sdejana/ColorSorter_C/scheme/gotova_PCB_2.png

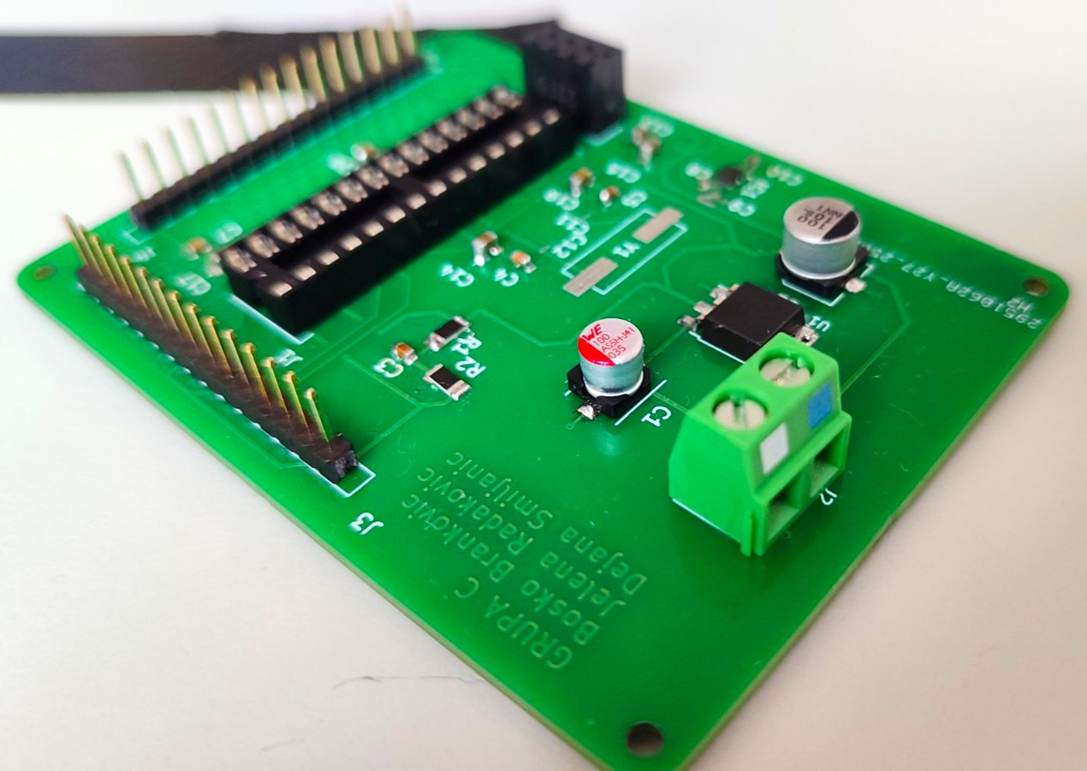
scheme/gotova_PCB_2.png
