sdejana/ColorSorter_C/scheme/3d_izgled_plocice.png

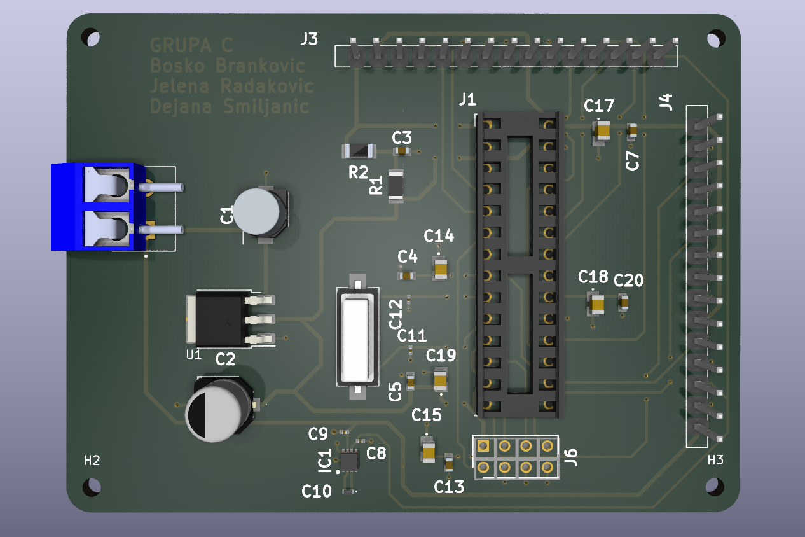
scheme/3d_izgled_plocice.png
