sdejana/ColorSorter_C/code/docs/latex/interrupt__manager_8h_source.tex

\doxysection{interrupt\+\_\+manager.\+h}
\hypertarget{interrupt__manager_8h_source}{}\label{interrupt__manager_8h_source}\index{include/interrupt\_manager.h@{include/interrupt\_manager.h}}
\mbox{\hyperlink{interrupt__manager_8h}{Go to the documentation of this file.}}
\begin{DoxyCode}{0}
\DoxyCodeLine{00001\ \textcolor{comment}{/******************************************************************************}}
\DoxyCodeLine{00002\ \textcolor{comment}{\ *\ Faculty\ of\ Electrical\ Engineering}}
\DoxyCodeLine{00003\ \textcolor{comment}{\ *\ MKS\ 2025}}
\DoxyCodeLine{00004\ \textcolor{comment}{\ *\ https://github.com/lukavidic/ColorSorter\_C.git}}
\DoxyCodeLine{00005\ \textcolor{comment}{\ *****************************************************************************}}
\DoxyCodeLine{00006\ \textcolor{comment}{\ *}}
\DoxyCodeLine{00007\ \textcolor{comment}{\ *\ @file\ \ \ \ interrupt\_manager.h}}
\DoxyCodeLine{00008\ \textcolor{comment}{\ *\ @brief\ \ \ Interrupt\ controller\ interface.}}
\DoxyCodeLine{00009\ \textcolor{comment}{\ *}}
\DoxyCodeLine{00010\ \textcolor{comment}{\ *\ @details}}
\DoxyCodeLine{00011\ \textcolor{comment}{\ *\ \ \ Provides\ initialization\ and\ control\ functions\ for\ the\ interrupt\ system,}}
\DoxyCodeLine{00012\ \textcolor{comment}{\ *\ \ \ including\ global\ enable/disable\ and\ retrieval\ of\ the\ current\ interrupt\ vector.}}
\DoxyCodeLine{00013\ \textcolor{comment}{\ *}}
\DoxyCodeLine{00014\ \textcolor{comment}{\ *********************************************************************************/}}
\DoxyCodeLine{00015\ }
\DoxyCodeLine{00016\ \textcolor{preprocessor}{\#ifndef\ \_INTERRUPT\_MANAGER\_H}}
\DoxyCodeLine{00017\ \textcolor{preprocessor}{\#define\ \_INTERRUPT\_MANAGER\_H}}
\DoxyCodeLine{00018\ }
\DoxyCodeLine{00019\ }
\DoxyCodeLine{00027\ \textcolor{keywordtype}{void}\ \mbox{\hyperlink{interrupt__manager_8h_a5c526129ee879458dff6755f5768a6e3}{INTERRUPT\_Initialize}}(\textcolor{keywordtype}{void});}
\DoxyCodeLine{00028\ }
\DoxyCodeLine{00035\ \textcolor{keyword}{inline}\ \textcolor{keyword}{static}\ \textcolor{keywordtype}{void}\ \mbox{\hyperlink{interrupt__manager_8h_a0e88e5f65ed34a762b4f9059e2a033ed}{INTERRUPT\_GlobalEnable}}(\textcolor{keywordtype}{void})}
\DoxyCodeLine{00036\ \{}
\DoxyCodeLine{00037\ \ \ \ \ \_\_builtin\_enable\_interrupts();}
\DoxyCodeLine{00038\ \}}
\DoxyCodeLine{00039\ }
\DoxyCodeLine{00047\ \textcolor{keyword}{inline}\ \textcolor{keyword}{static}\ \textcolor{keywordtype}{void}\ \mbox{\hyperlink{interrupt__manager_8h_ac2f23c6185e515ff80fb2f2549b0f10d}{INTERRUPT\_GlobalDisable}}(\textcolor{keywordtype}{void})}
\DoxyCodeLine{00048\ \{}
\DoxyCodeLine{00049\ \ \ \ \ \_\_builtin\_disable\_interrupts();}
\DoxyCodeLine{00050\ \}}
\DoxyCodeLine{00051\ }
\DoxyCodeLine{00060\ \textcolor{keyword}{inline}\ \textcolor{keyword}{static}\ uint16\_t\ \mbox{\hyperlink{interrupt__manager_8h_a4f2787d36434a2df6c0c6009108da708}{INTERRUPT\_VectorNumberGet}}(\textcolor{keywordtype}{void})}
\DoxyCodeLine{00061\ \{}
\DoxyCodeLine{00062\ \ \ \ \ \textcolor{keywordflow}{return}\ \_VECNUM;\ }
\DoxyCodeLine{00063\ \}}
\DoxyCodeLine{00064\ }
\DoxyCodeLine{00065\ \textcolor{preprocessor}{\#endif\ }\textcolor{comment}{/*\ \_INTERRUPT\_MANAGER\_H\ */}\textcolor{preprocessor}{}}

\end{DoxyCode}
