sdejana/ColorSorter_C/code/docs/latex/pin__manager_8c.tex

\doxysection{src/pin\+\_\+manager.c File Reference}
\hypertarget{pin__manager_8c}{}\label{pin__manager_8c}\index{src/pin\_manager.c@{src/pin\_manager.c}}
{\ttfamily \#include $<$xc.\+h$>$}\newline
{\ttfamily \#include $<$stdio.\+h$>$}\newline
{\ttfamily \#include "{}pin\+\_\+manager.\+h"{}}\newline
Include dependency graph for pin\+\_\+manager.\+c\+:
% FIG 0
\doxysubsubsection*{Functions}
\begin{DoxyCompactItemize}
\item 
void \mbox{\hyperlink{pin__manager_8c_a50357774183a136d9490f64ad0d5c6cb}{PIN\+\_\+\+MANAGER\+\_\+\+Initialize}} (void)
\begin{DoxyCompactList}\small\item\em Initializes pin manager settings. \end{DoxyCompactList}\end{DoxyCompactItemize}

\doxysubsection{Function Documentation}
\Hypertarget{pin__manager_8c_a50357774183a136d9490f64ad0d5c6cb}\index{pin\_manager.c@{pin\_manager.c}!PIN\_MANAGER\_Initialize@{PIN\_MANAGER\_Initialize}}
\index{PIN\_MANAGER\_Initialize@{PIN\_MANAGER\_Initialize}!pin\_manager.c@{pin\_manager.c}}
\doxysubsubsection{\texorpdfstring{PIN\_MANAGER\_Initialize()}{PIN\_MANAGER\_Initialize()}}
{\footnotesize\ttfamily \label{pin__manager_8c_a50357774183a136d9490f64ad0d5c6cb} 
void PIN\+\_\+\+MANAGER\+\_\+\+Initialize (\begin{DoxyParamCaption}\item[{void}]{}{}\end{DoxyParamCaption})}

Initializes pin manager settings. 

Initialize pin manager settings.

Configures open-\/drain control registers, analog/digital pins, and can include PPS mappings if enabled. Commented-\/out sections illustrate latch settings, GPIO direction, and pull-\/ups/-\/downs.
