sdejana/ColorSorter_C/code/docs/latex/system_8h.tex

\doxysection{include/system.h File Reference}
\hypertarget{system_8h}{}\label{system_8h}\index{include/system.h@{include/system.h}}
{\ttfamily \#include "{}xc.\+h"{}}\newline
{\ttfamily \#include "{}stdint.\+h"{}}\newline
{\ttfamily \#include "{}pin\+\_\+manager.\+h"{}}\newline
{\ttfamily \#include "{}interrupt\+\_\+manager.\+h"{}}\newline
Include dependency graph for system.\+h\+:
% FIG 0
This graph shows which files directly or indirectly include this file\+:
% FIG 1
\doxysubsubsection*{Macros}
\begin{DoxyCompactItemize}
\item 
\#define \mbox{\hyperlink{system_8h_a024148e99a7143db044a48216664d03d}{\+\_\+\+XTAL\+\_\+\+FREQ}}~32000000\+UL
\begin{DoxyCompactList}\small\item\em CPU clock frequency in Hertz (32 MHz). \end{DoxyCompactList}\end{DoxyCompactItemize}
\doxysubsubsection*{Functions}
\begin{DoxyCompactItemize}
\item 
void \mbox{\hyperlink{system_8h_a5e8391114a0cf91ac20002be25e3d352}{SYSTEM\+\_\+\+Initialize}} (void)
\begin{DoxyCompactList}\small\item\em Perform system-\/level initialization. \end{DoxyCompactList}\end{DoxyCompactItemize}

\doxysubsection{Macro Definition Documentation}
\Hypertarget{system_8h_a024148e99a7143db044a48216664d03d}\index{system.h@{system.h}!\_XTAL\_FREQ@{\_XTAL\_FREQ}}
\index{\_XTAL\_FREQ@{\_XTAL\_FREQ}!system.h@{system.h}}
\doxysubsubsection{\texorpdfstring{\_XTAL\_FREQ}{\_XTAL\_FREQ}}
{\footnotesize\ttfamily \label{system_8h_a024148e99a7143db044a48216664d03d} 
\#define \+\_\+\+XTAL\+\_\+\+FREQ~32000000\+UL}

CPU clock frequency in Hertz (32 MHz). 

\doxysubsection{Function Documentation}
\Hypertarget{system_8h_a5e8391114a0cf91ac20002be25e3d352}\index{system.h@{system.h}!SYSTEM\_Initialize@{SYSTEM\_Initialize}}
\index{SYSTEM\_Initialize@{SYSTEM\_Initialize}!system.h@{system.h}}
\doxysubsubsection{\texorpdfstring{SYSTEM\_Initialize()}{SYSTEM\_Initialize()}}
{\footnotesize\ttfamily \label{system_8h_a5e8391114a0cf91ac20002be25e3d352} 
void SYSTEM\+\_\+\+Initialize (\begin{DoxyParamCaption}\item[{void}]{}{}\end{DoxyParamCaption})}

Perform system-\/level initialization. 

Sets up core peripherals by calling initialization routines for pin manager, interrupt manager, and other modules as needed.

Perform system-\/level initialization.

Calls the generated interrupt manager initialization and the SPI1 driver initialization. Pin manager init is commented out and can be enabled if pin setup via MCC is required. Here is the call graph for this function\+:
% FIG 2
Here is the caller graph for this function\+:
% FIG 3
