sdejana/ColorSorter_C/docs/ColorSorter_Analiza_servo_button_led.pdf

Servo motor, button modul i LED modul – povezivanje i pinovi

- Servo motor

Povezuje se pomoću tri pina:

Vdd – potrebno dovesti napon od 5V, tj. 4.5V koliko imamo. Uzećemo direktno sa napajanja.

GND – uzemljenje.

PWM – pin na mikrokontroleru koji ima PWM signal kao jedan od onih koji se mogu generisati

- Button modul

Vcc

GND

Jedan pin koji podržava GPIO, tj. direktno upravljanje

- LED modul

Vcc

GND

Jedan pin koji podržava GPIO, tj. direktno upravljanje
