sdejana/ColorSorter_C/docs/ColorSorter_Dodatne_komponente_šifarnik.pdf

Komponenta: | Šifra u katalogu (Mouser electronics): | Količina: | Cijena (€): | Odobreno (DA/NE):
Pin header, 15 pinova, muški (M20-9991546) | 855-M20-9991546 | 2 | 1.00
Mikrokontroler | 579-24FJ64GA702ISO | 1 | 1.67
Screw konektor za bateriju, dva izvoda | NN | 1 | NN | Nabavljamo samostalno
Baterije AA 2500mh | NN | 3 | NN
3.3V, regulator napona | 926-LM1117DTX3.3NOPB | 1 | 1.22
Kristal kvarca | 559-FOXSD080-20-LF | 1 | 0.25
5V regulator | 595-LM2775DSGT | 1 | 1.17
Kondenzator 10uF, elektrolitski | 80-EDH106M250A9RAA | 1 | 1.59
Kondenzator 10uF, keramički | 80-C0805C106M4P | 10 | 1.60
Kondenzator 100uF, elektrolitski | 594-MAL214699103E3 | 1 | 1.95
Kondenzator 0.1uF, keramički | 80-C0603C104J1RAUTO | 10 | 1.25

Kondenzator 2.2uF, keramički | 187-CL03A225MO5C65C | 2 | 0.932
Kondenzator 1uF, keramički | 963-MAASL105CD7105MF | 1 | 0.133
Kondenzator 10pF, keramički | 581-02013A100J | 2 | 0.22
Otpornik 270Ω | 71-RCA1206270RJNEA | 1 | 0.171
Otpornik 10kΩ | 71-CRCW1206J-10K-E3 | 2 | 0.19
Pin soket, 6 ulaza, ženski | 571-5-534206-4 | 1 | 1.53
Kućište za mikrokontroler, 28 pinova | 571-1-2199298-9 | 1 | 0.63

Ukupno:
15.506
(€)

~30.3(BAM)

BATERIJE NISU UKLJUČENE U KONAČNU CIJENU.
