sdejana/ColorSorter_C/docs/sema-najnovija.png

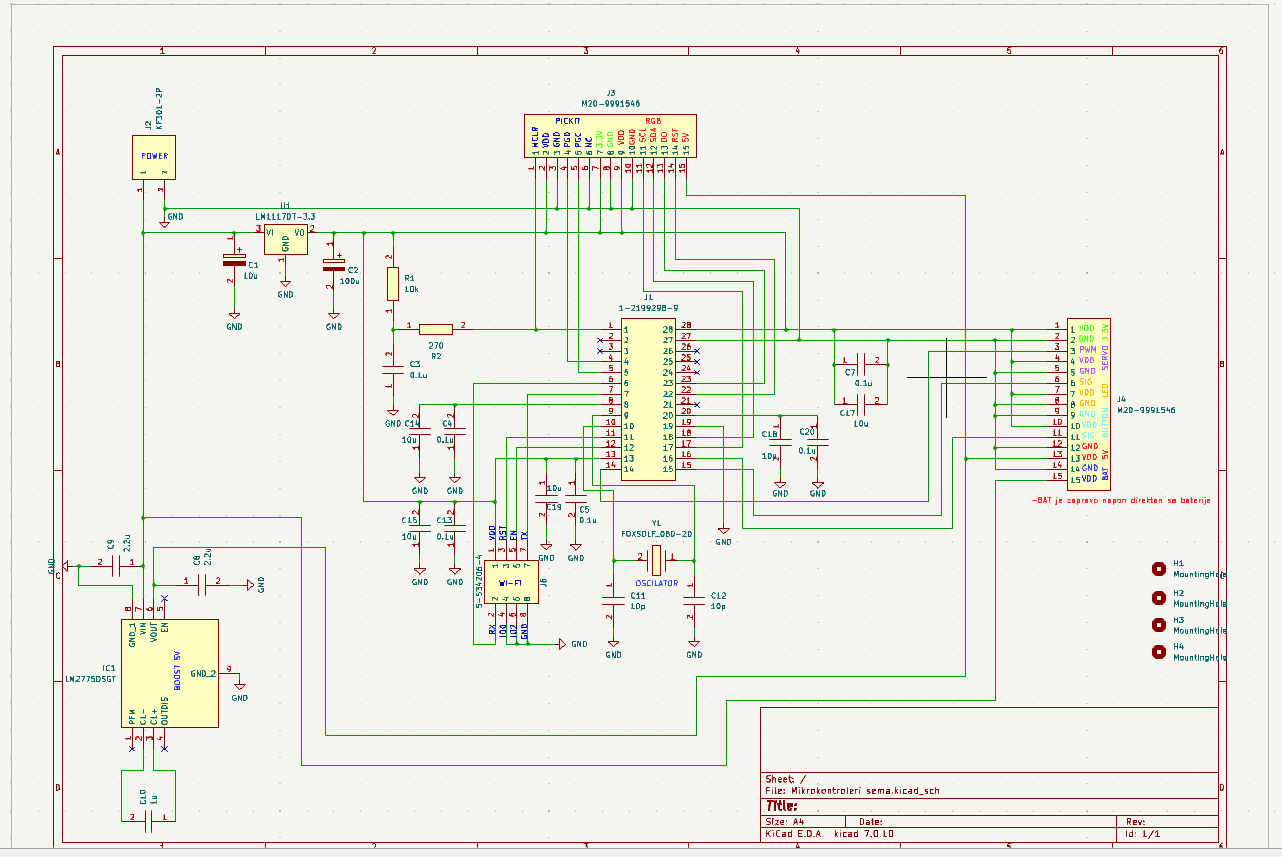
docs/sema-najnovija.png
