sdejana/ColorSorter_C/scheme/3d_izgled_plocice_2.png

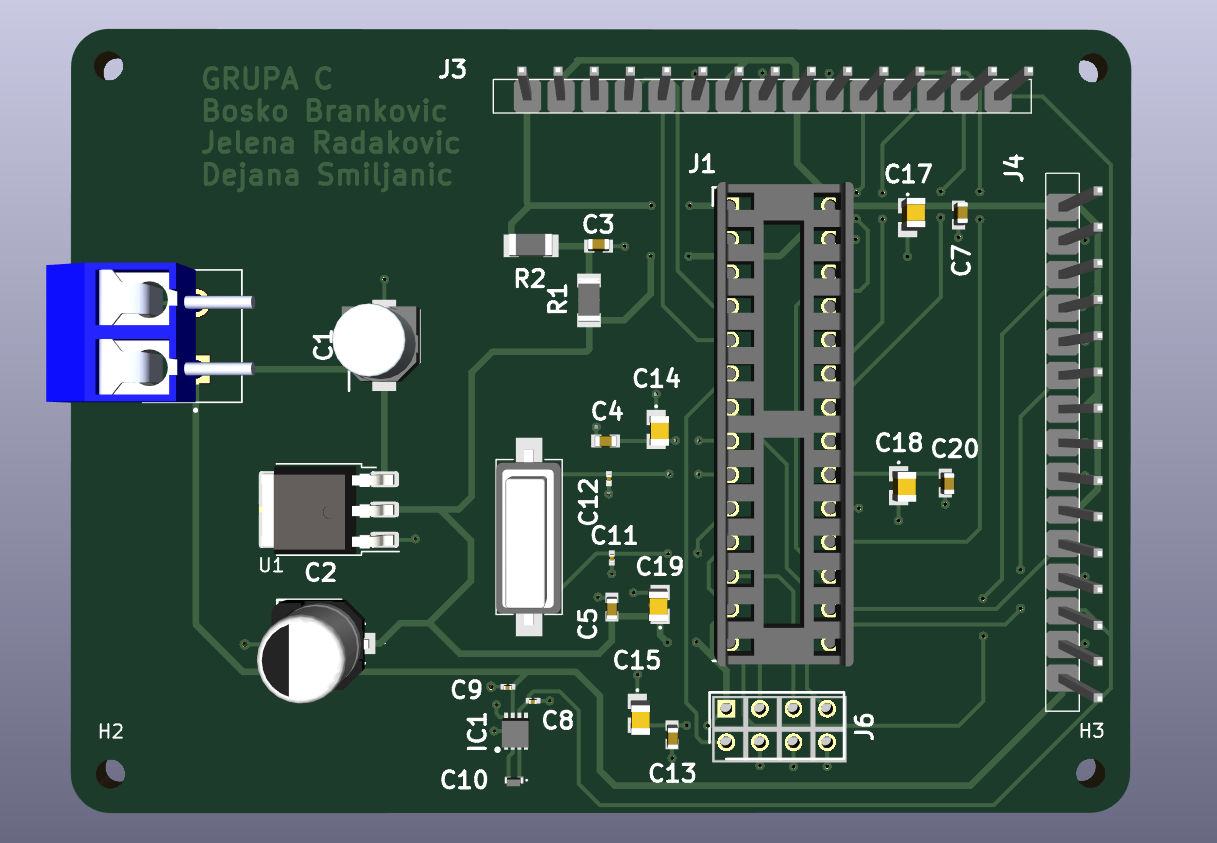
scheme/3d_izgled_plocice_2.png
