sdejana/ColorSorter_C/scheme/button_scheme.png

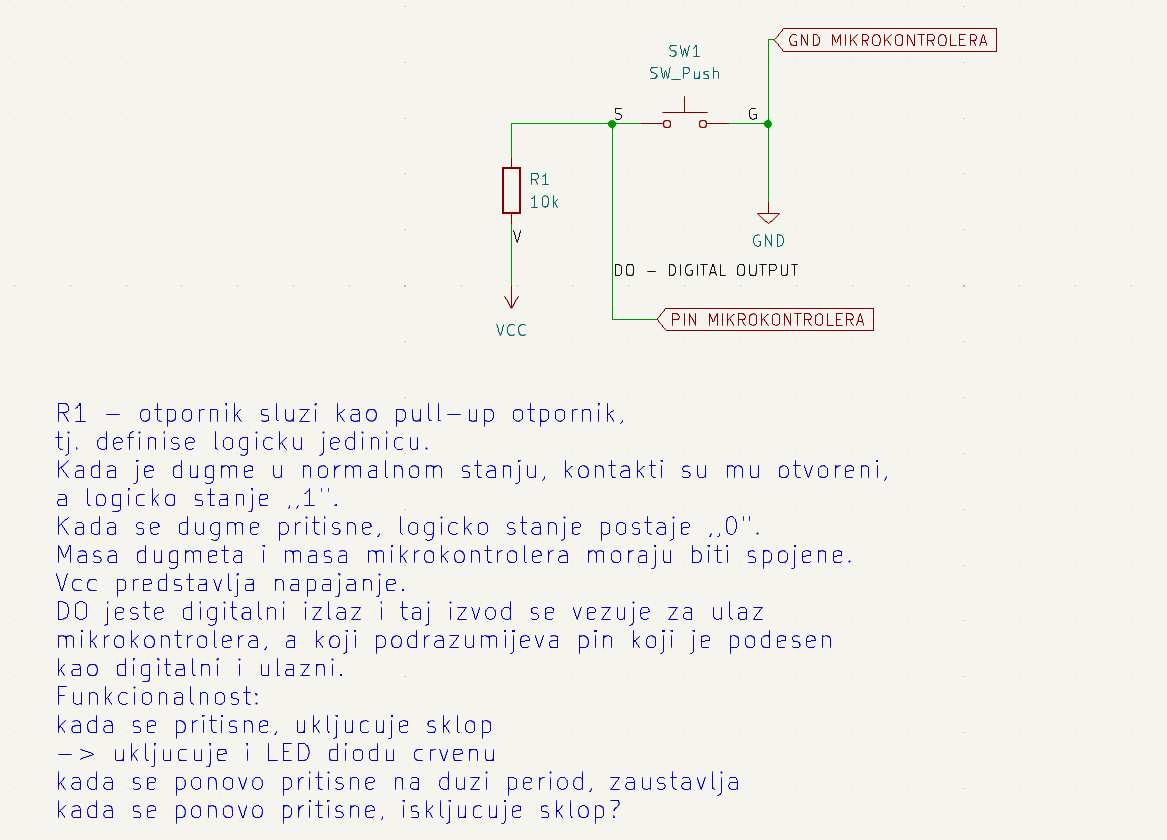
scheme/button_scheme.png
