sdejana/ColorSorter_C/scheme/gotova_PCB_1.png

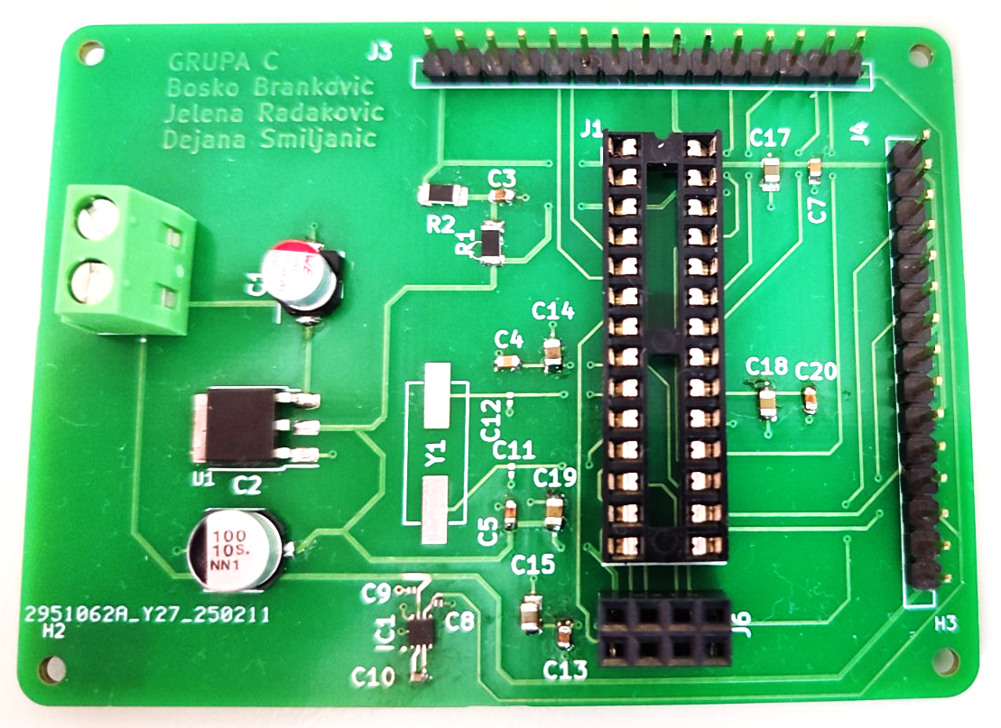
scheme/gotova_PCB_1.png
