sdejana/ColorSorter_C/scheme/izrutirana_plocica.png

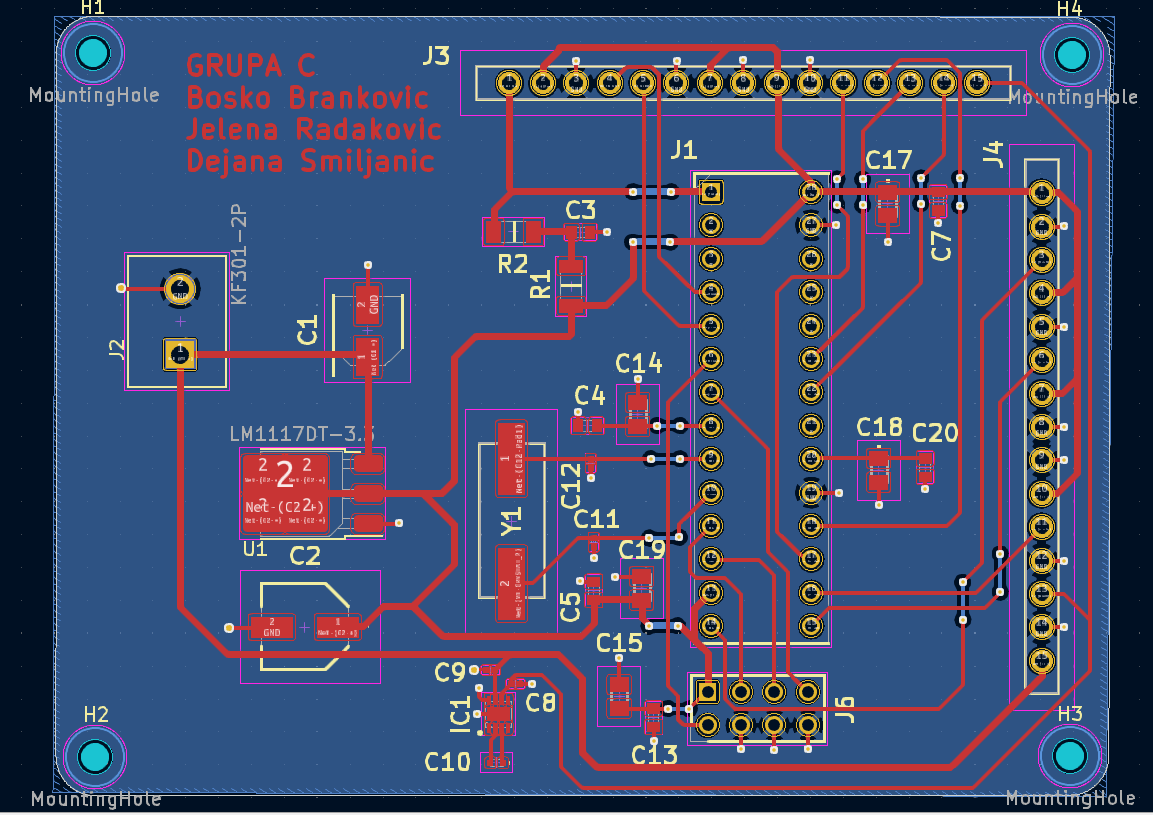
scheme/izrutirana_plocica.png
