sdejana/ColorSorter_C/scheme/osnovna_konfiguracija_uc_scheme.png

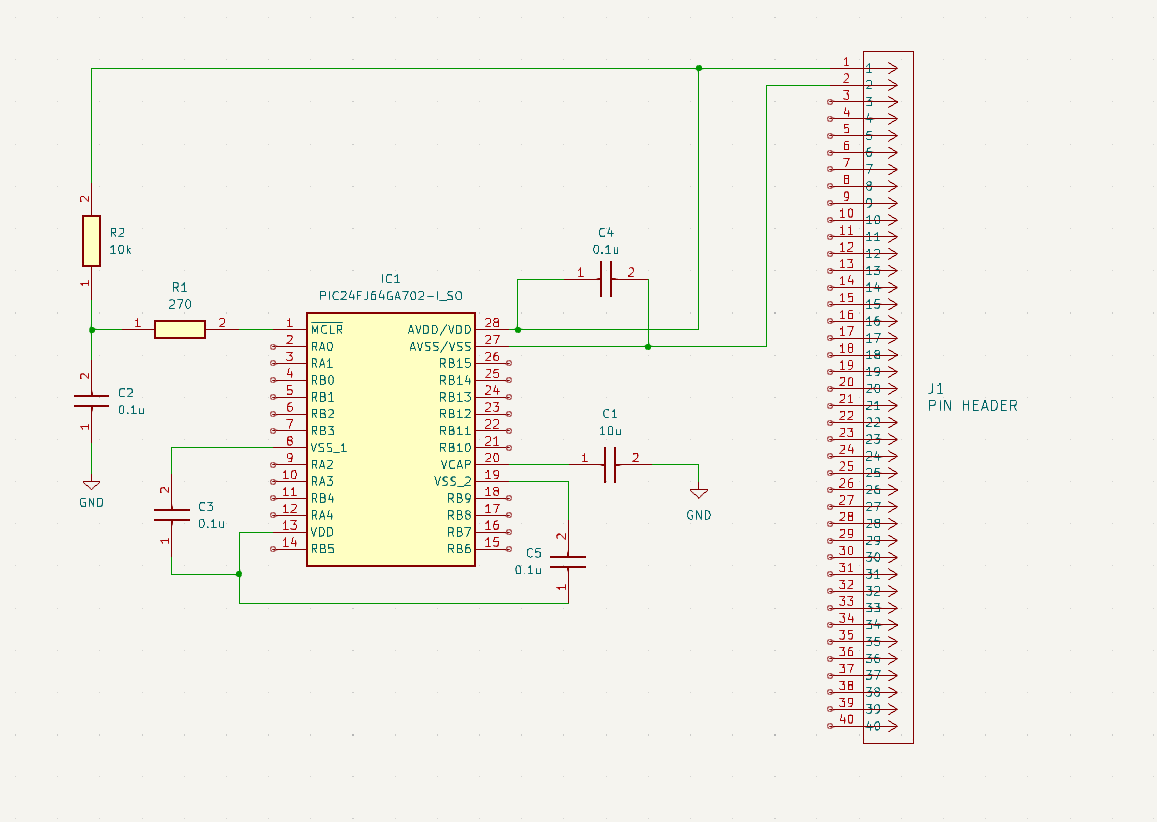
scheme/osnovna_konfiguracija_uc_scheme.png
