sdejana/ColorSorter_C/scheme/pcb_finalna_verzija.png

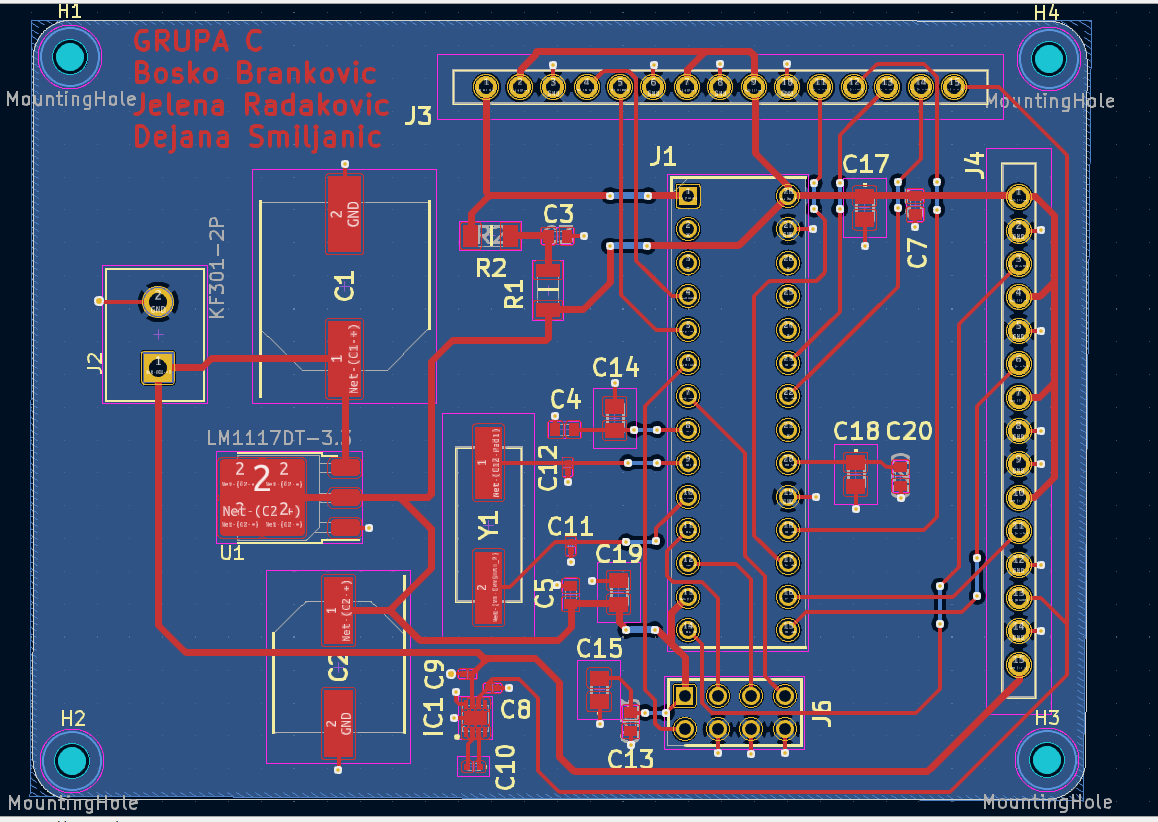
scheme/pcb_finalna_verzija.png
