sdejana/ColorSorter_C/scheme/pcb_izmjena.png

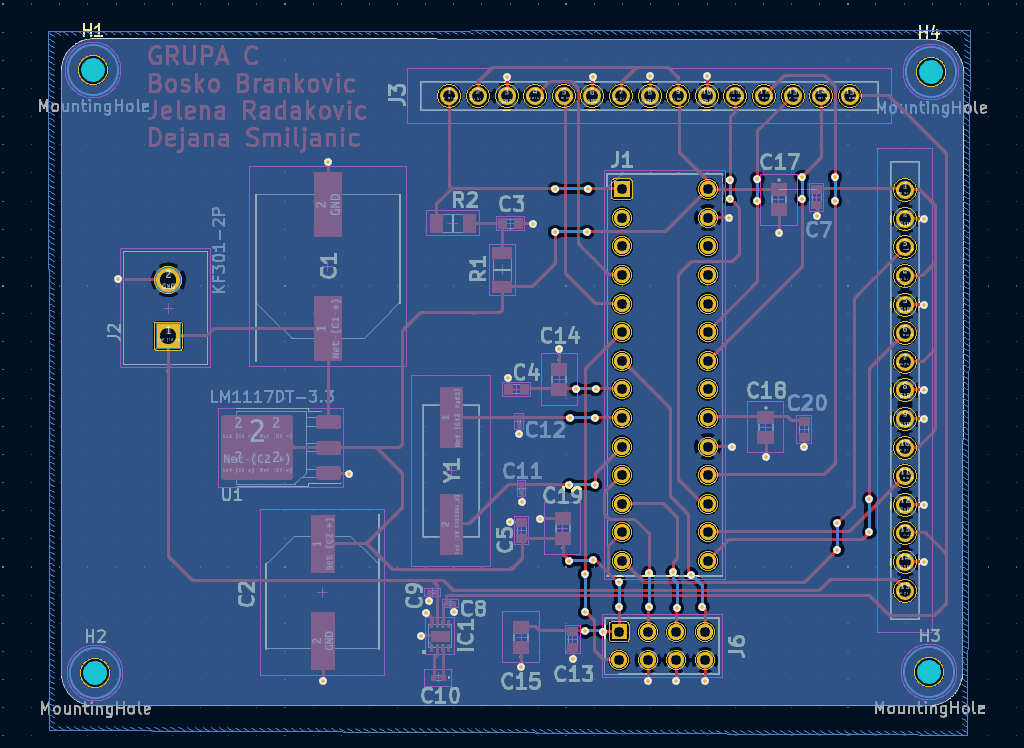
scheme/pcb_izmjena.png
