sdejana/ColorSorter_C/scheme/pcb_izmjena_.png

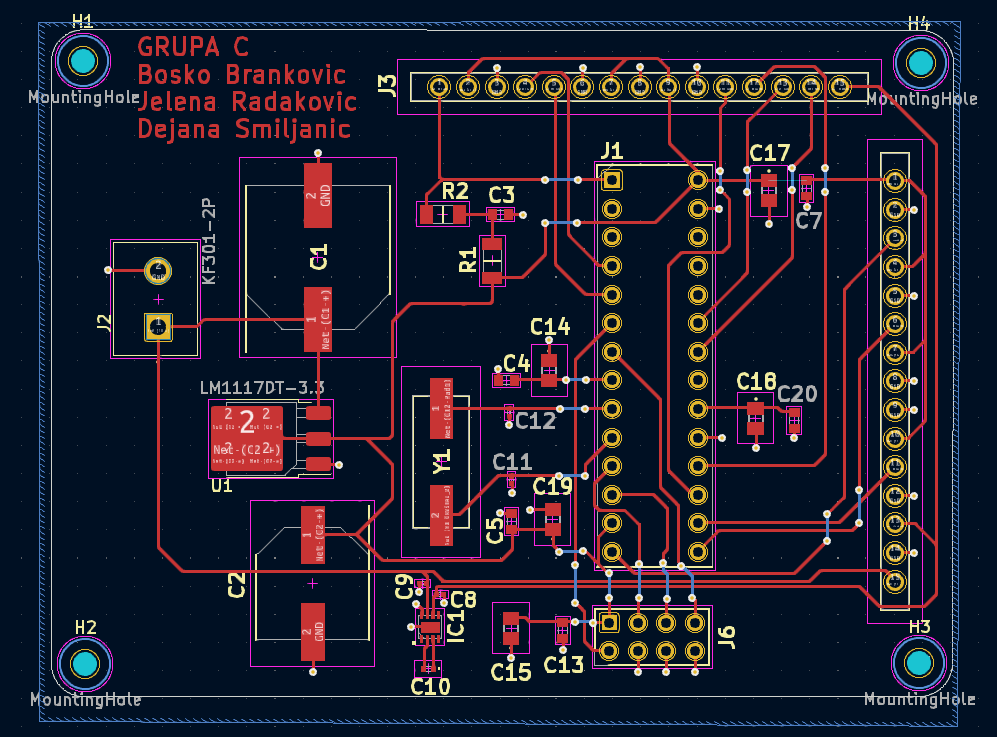
scheme/pcb_izmjena_.png
