sdejana/ColorSorter_C/scheme/pcb_verzija_1_.png

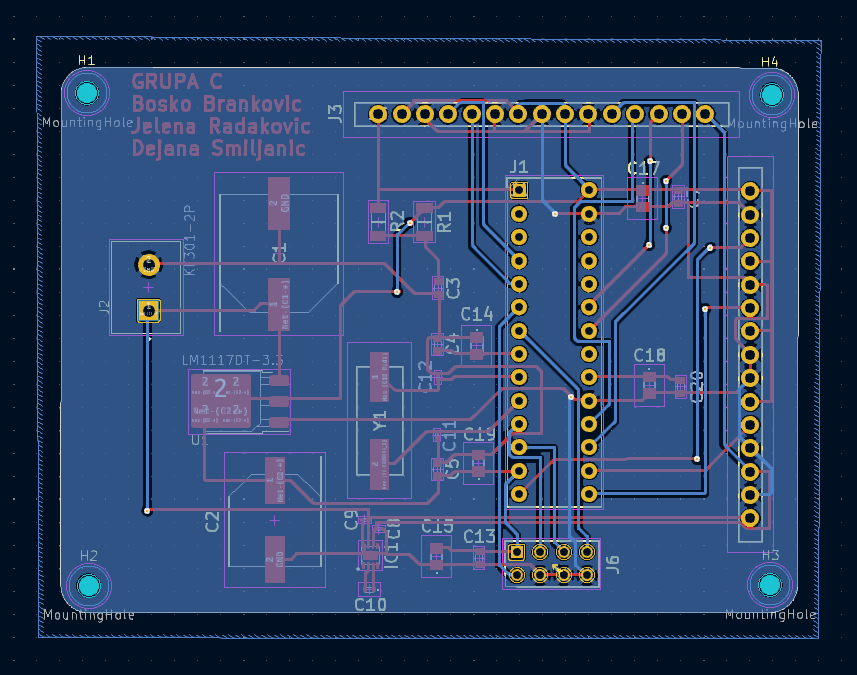
scheme/pcb_verzija_1_.png
