sdejana/ColorSorter_C/scheme/projektovana_plocica_finalna_verzija.png

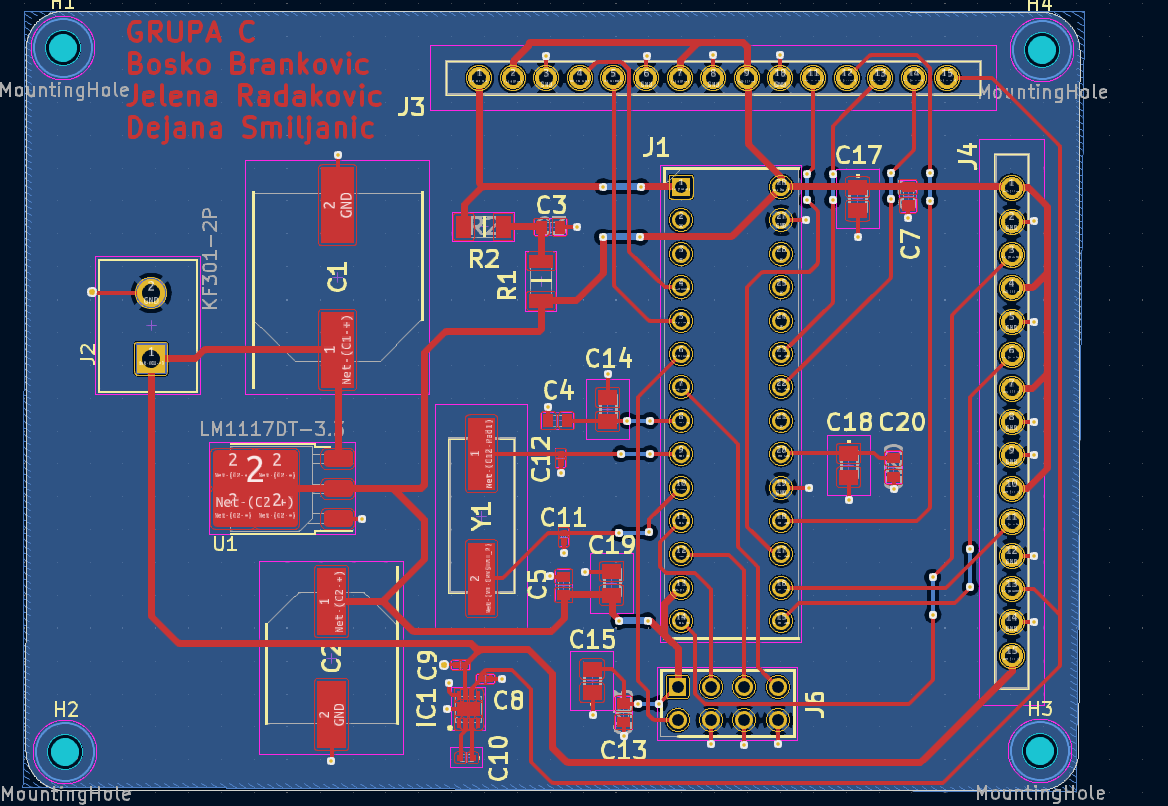
scheme/projektovana_plocica_finalna_verzija.png
