sdejana/ColorSorter_C/scheme/projektovana_plocica_sema_v2.png

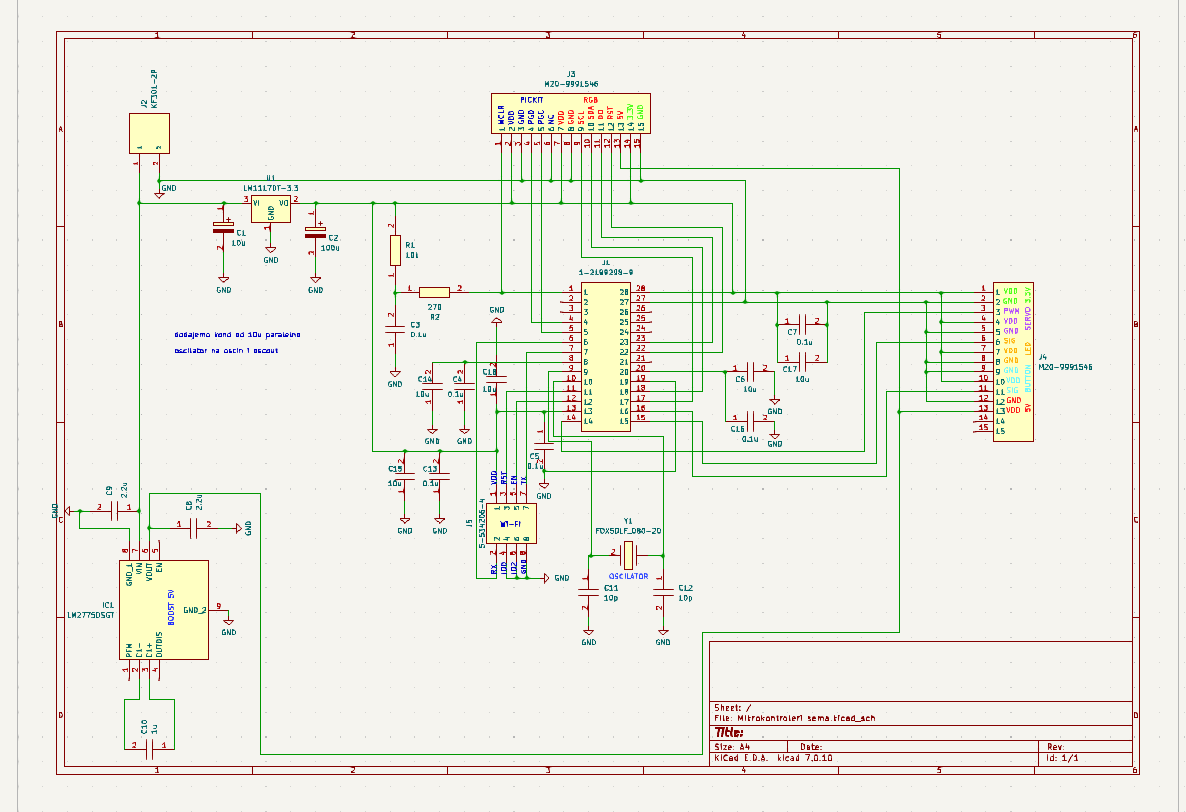
scheme/projektovana_plocica_sema_v2.png
