sdejana/ColorSorter_C/scheme/projektovana_plocica_v1.png

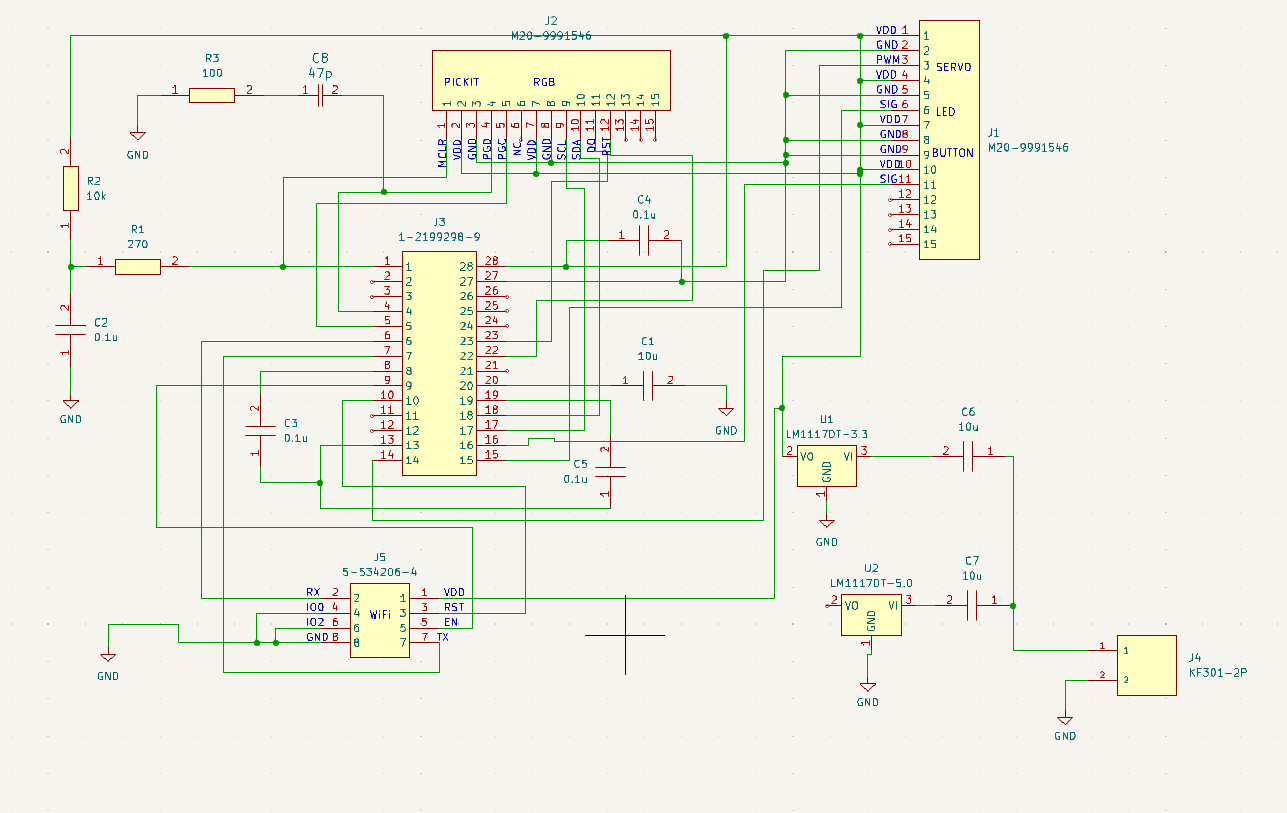
scheme/projektovana_plocica_v1.png
