sdejana/ColorSorter_C/scheme/projektovana_sema_finalna_verzija.png

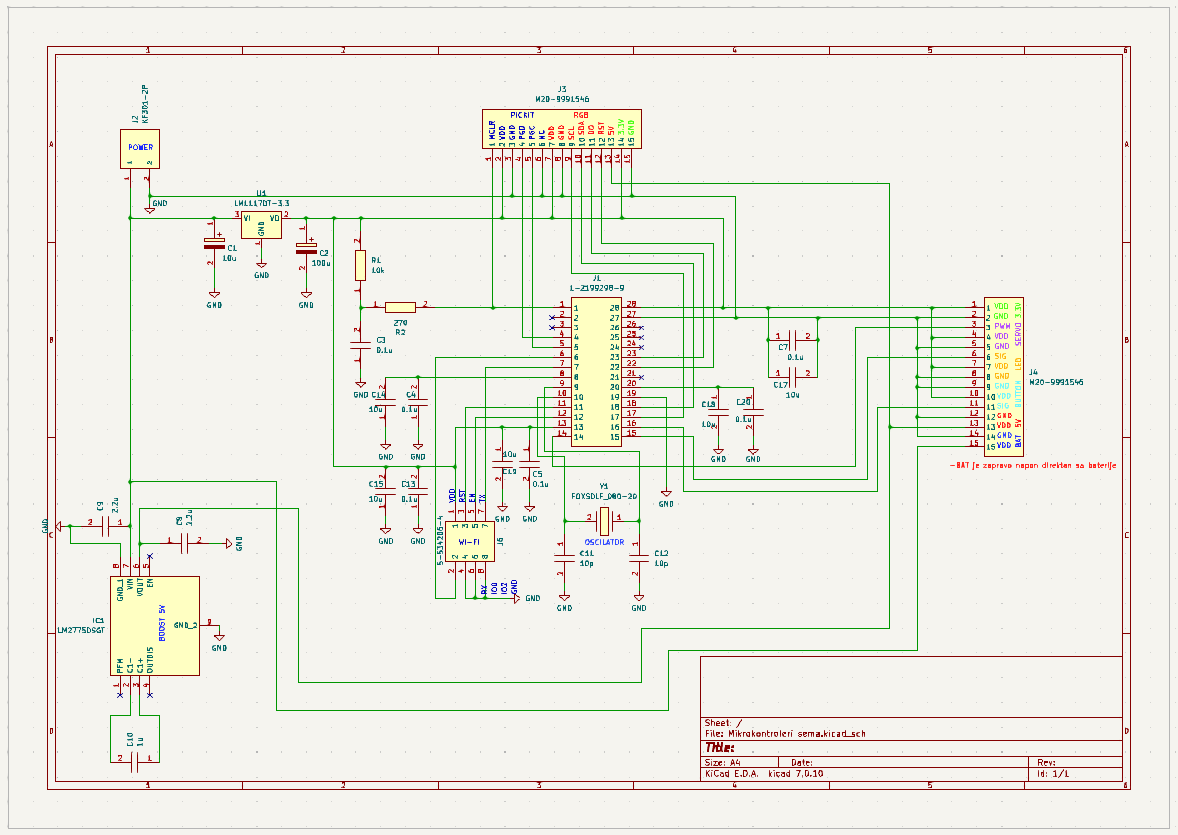
scheme/projektovana_sema_finalna_verzija.png
