sdejana/ColorSorter_C/scheme/semakicked.png

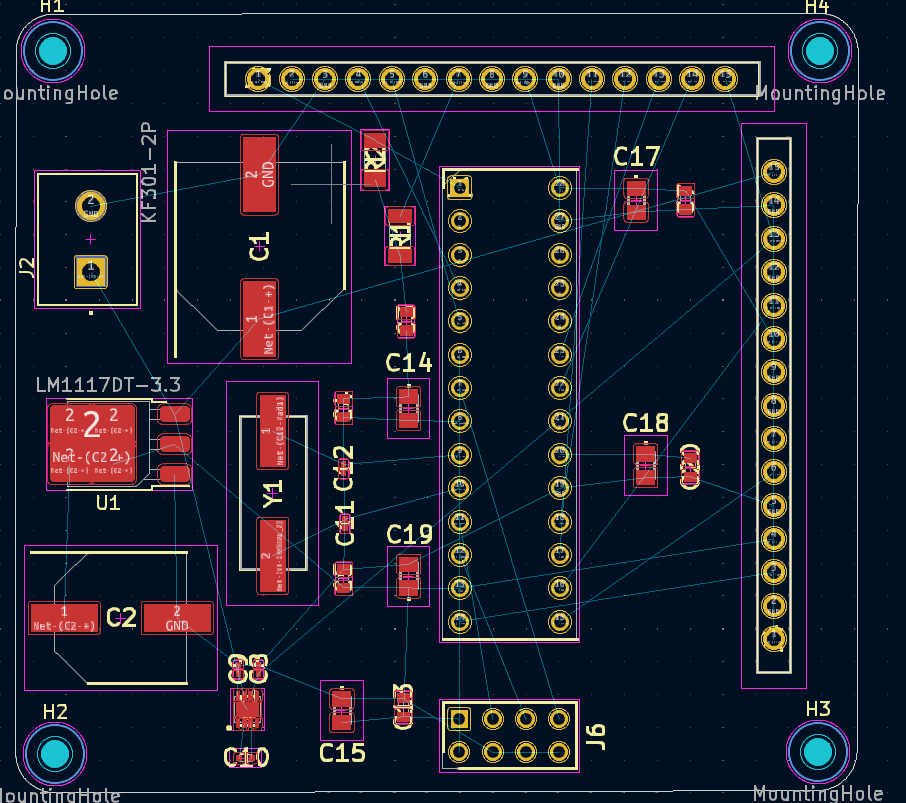
scheme/semakicked.png
