sdejana/ColorSorter_C/scheme/servo_motor_scheme.png

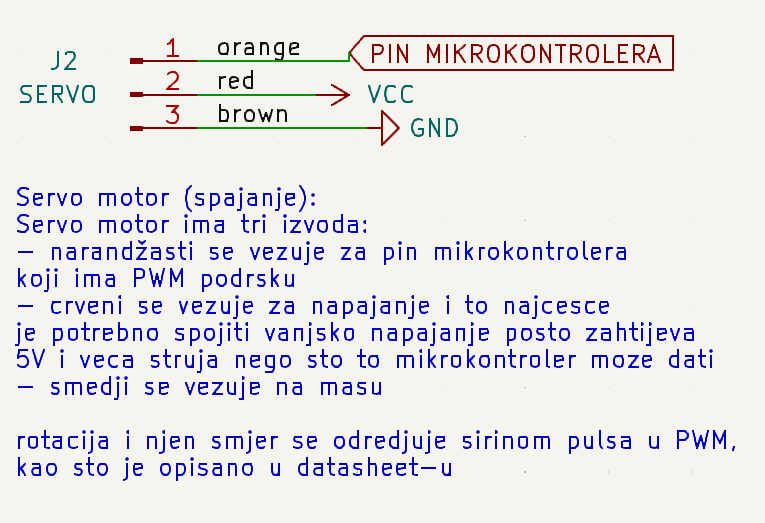
scheme/servo_motor_scheme.png
