sdejana/ColorSorter_C/footprints/0.1u_kondenzator_keramicki/C0603C104J1RACAUTO/3D/C0603C104J1RACAUTO.stp

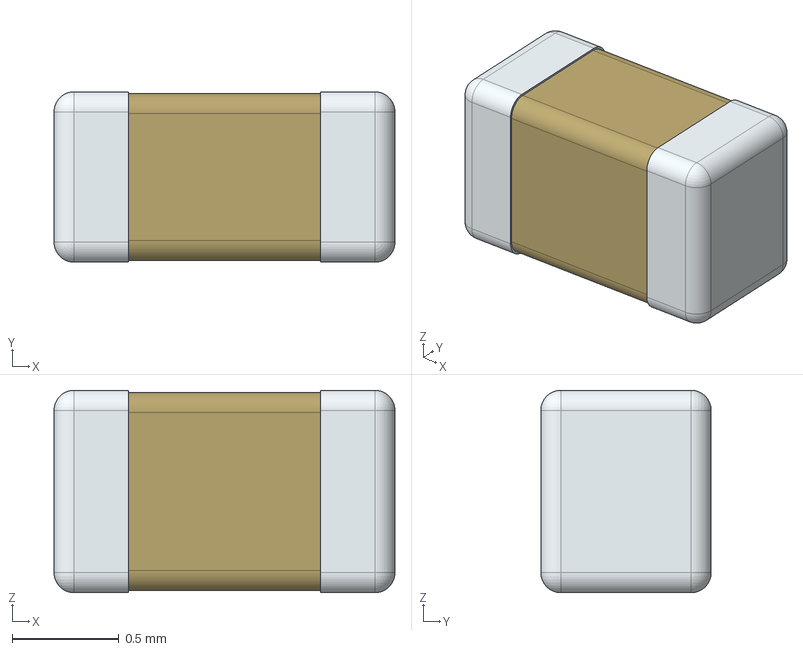
[picture p32: CAD file, 2025-05-07]
footprints/0.1u_kondenzator_keramicki/C0603C104J1RACAUTO/3D/C0603C104J1RACAUTO.stp
1.60 x 0.8 x 0.95 mm
