sdejana/ColorSorter_C/footprints/100u_kondenzator_elektrolitski/EEE-FT1V101AP/3D/EEE-FT1V101AP.stp

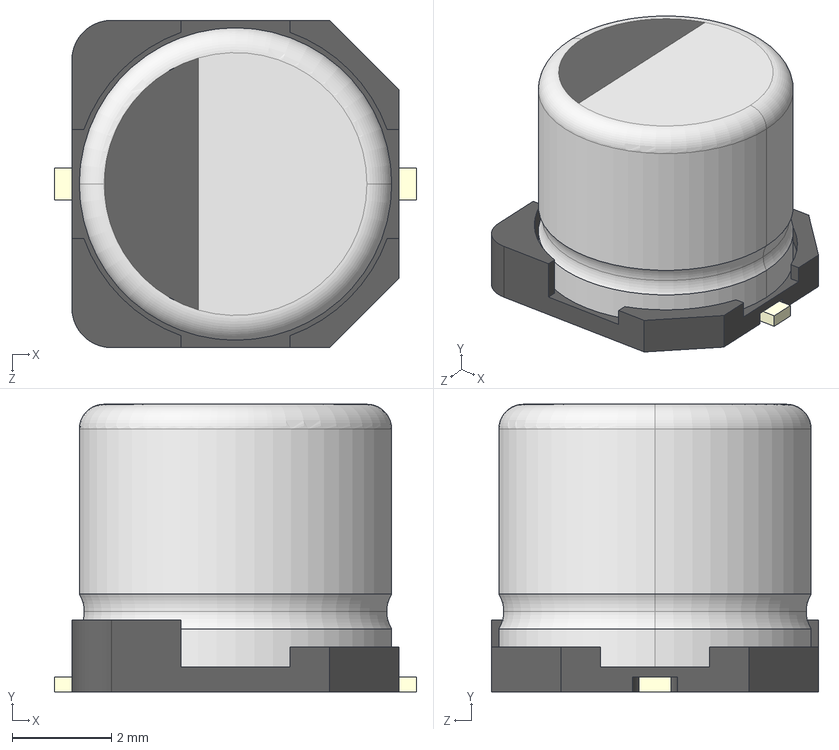
[picture p33: CAD file, 2025-05-07]
footprints/100u_kondenzator_elektrolitski/EEE-FT1V101AP/3D/EEE-FT1V101AP.stp
7.30 x 5.80 x 6.60 mm
標準SIZE CODE D-001
標準SIZE CODE D-002
標準SIZE CODE D-003 x 2
