sdejana/ColorSorter_C/footprints/10k_otpornik/CRCW120610K0JNEA/3D/CRCW120610K0JNEA.stp

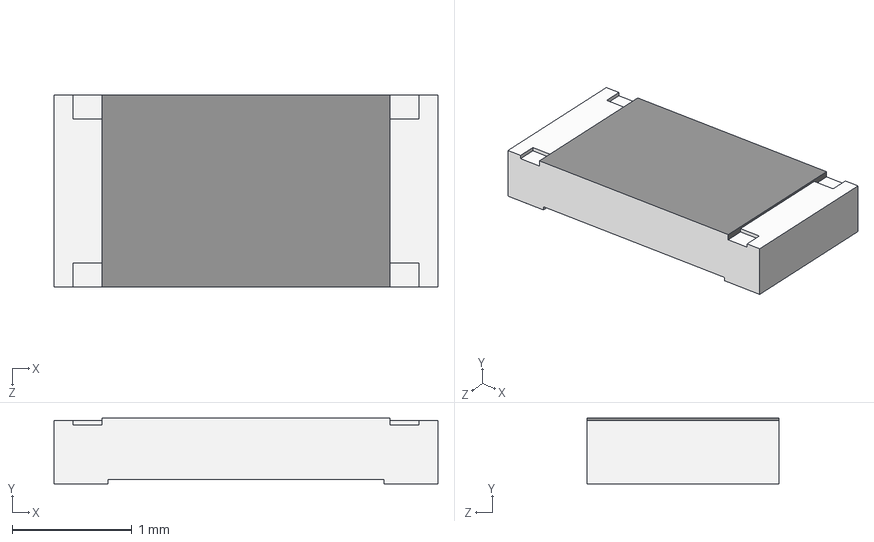
[picture p34: CAD file, 2025-05-07]
footprints/10k_otpornik/CRCW120610K0JNEA/3D/CRCW120610K0JNEA.stp
3.20 x 0.55 x 1.60 mm
