sdejana/ColorSorter_C/footprints/10u_kondenzator_elektrolitski/865230542002/KiCad/CAPAE530X550N-(C).stp

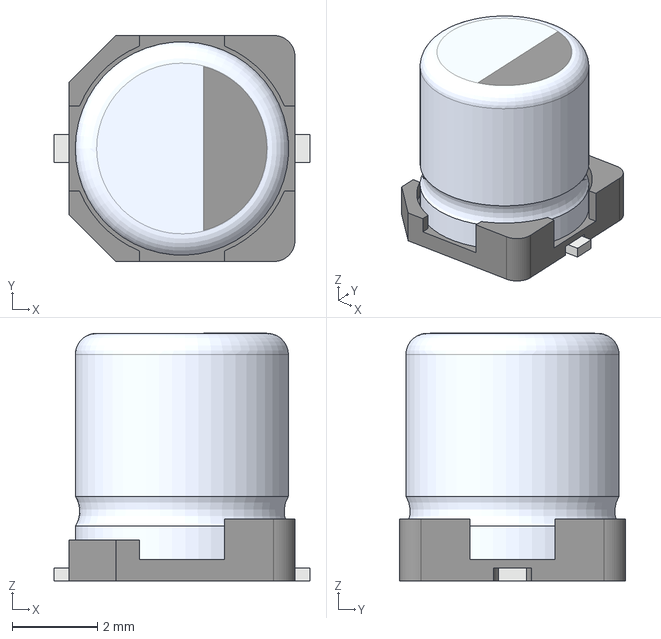
[picture p35: CAD file, 2025-05-07]
footprints/10u_kondenzator_elektrolitski/865230542002/KiCad/CAPAE530X550N-(C).stp
6.00 x 5.30 x 5.80 mm
