sdejana/ColorSorter_C/footprints/10u_kondenzator_keramicki/C0805C106M4PACTU/3D/C0805C106M4PACTU.stp

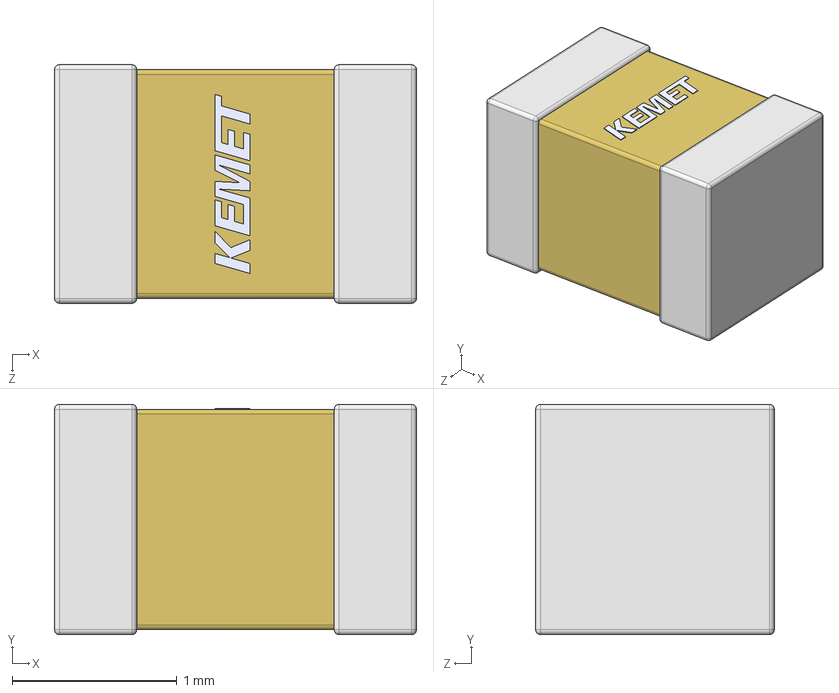
[picture p36: CAD file, 2025-05-07]
footprints/10u_kondenzator_keramicki/C0805C106M4PACTU/3D/C0805C106M4PACTU.stp
2.20 x 1.40 x 1.45 mm
