sdejana/ColorSorter_C/footprints/1u_kondenzator_keramicki/MAASL105CD7105MFCA01/3D/MAASL105CD7105MFCA01.stp

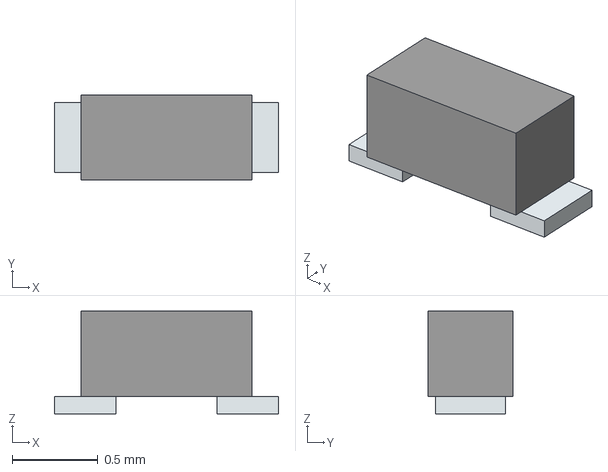
[picture p37: CAD file, 2025-05-07]
footprints/1u_kondenzator_keramicki/MAASL105CD7105MFCA01/3D/MAASL105CD7105MFCA01.stp
1.31 x 0.5 x 0.6 mm
Pins
