sdejana/ColorSorter_C/footprints/2.2u_kondenzator_keramicki/CL03A225MO5C65C/3D/CL03A225MO5C65C.stp

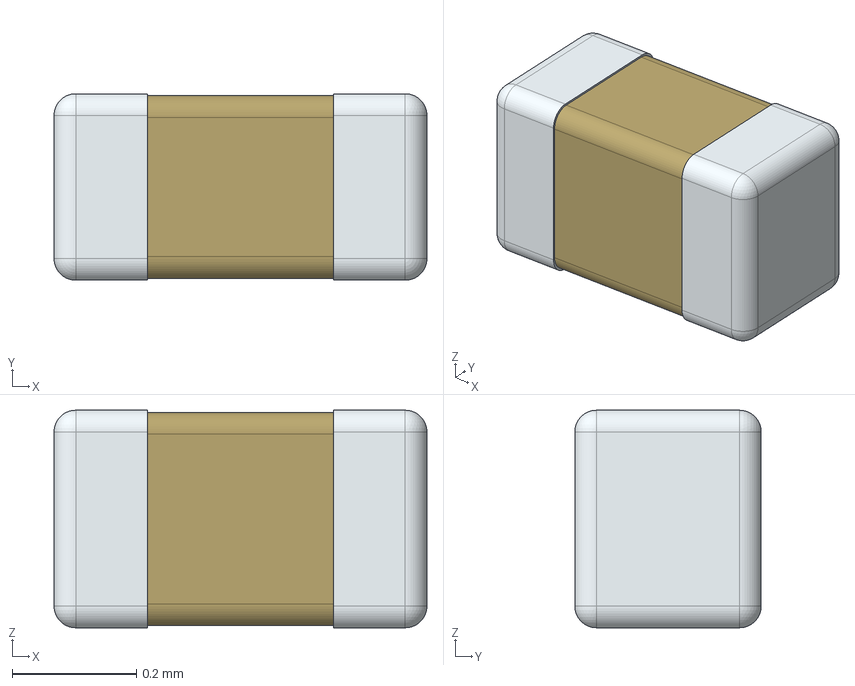
[picture p38: CAD file, 2025-05-07]
footprints/2.2u_kondenzator_keramicki/CL03A225MO5C65C/3D/CL03A225MO5C65C.stp
0.6 x 0.3 x 0.35 mm
