sdejana/ColorSorter_C/footprints/270_otpornik/ERA-8AEB131V/3D/ERA-8AEB131V.stp

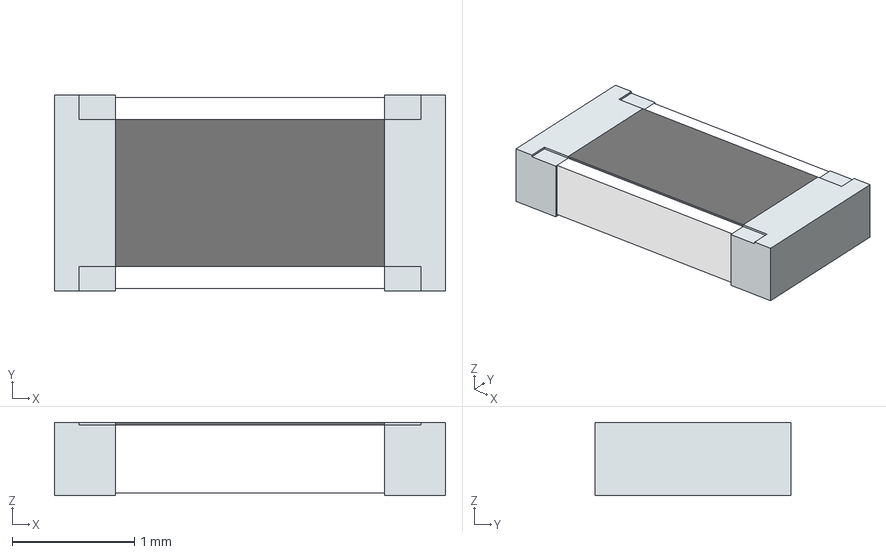
[picture p39: CAD file, 2025-05-07]
footprints/270_otpornik/ERA-8AEB131V/3D/ERA-8AEB131V.stp
3.20 x 1.60 x 0.6 mm
solidBody
Terminal
solidTop
