sdejana/ColorSorter_C/footprints/5V_boost_regulator/LM2775DSGT/3D/LM2775DSGT.stp

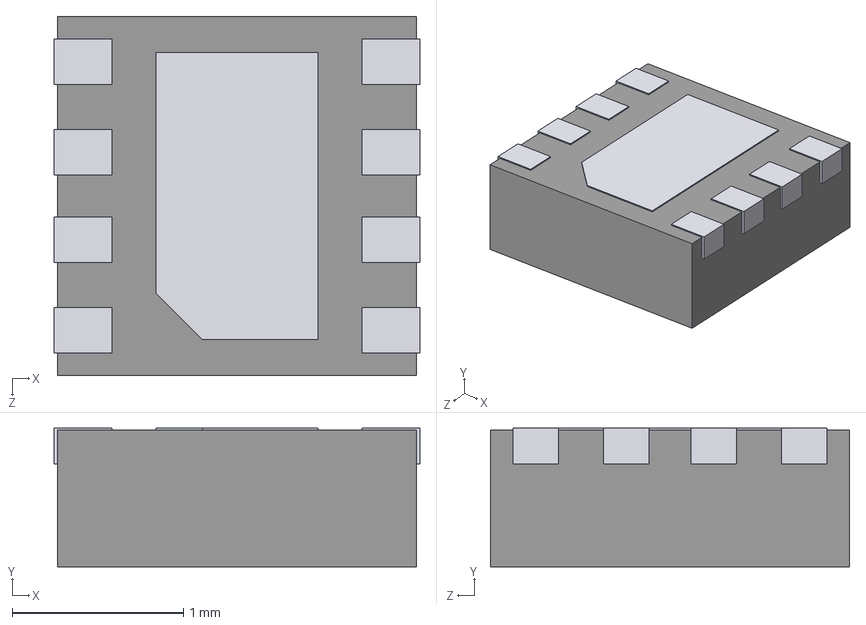
[picture p40: CAD file, 2025-05-07]
footprints/5V_boost_regulator/LM2775DSGT/3D/LM2775DSGT.stp
2.14 x 0.81 x 2.10 mm
