sdejana/ColorSorter_C/footprints/kristal_kvarca/FOXSDLF_080-20/3D/FOXSDLF_080-20.stp

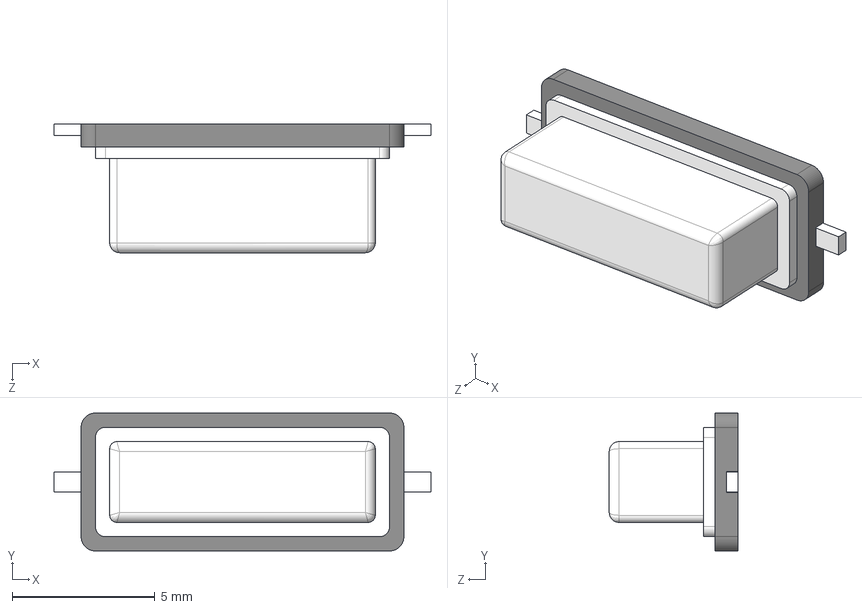
[picture p41: CAD file, 2025-05-07]
footprints/kristal_kvarca/FOXSDLF_080-20/3D/FOXSDLF_080-20.stp
13.2 x 4.83 x 4.50 mm
