sdejana/ColorSorter_C/footprints/kuciste_za_mikrokontroler_28_pinova/1-2199298-9/3D/1-2199298-9.stp

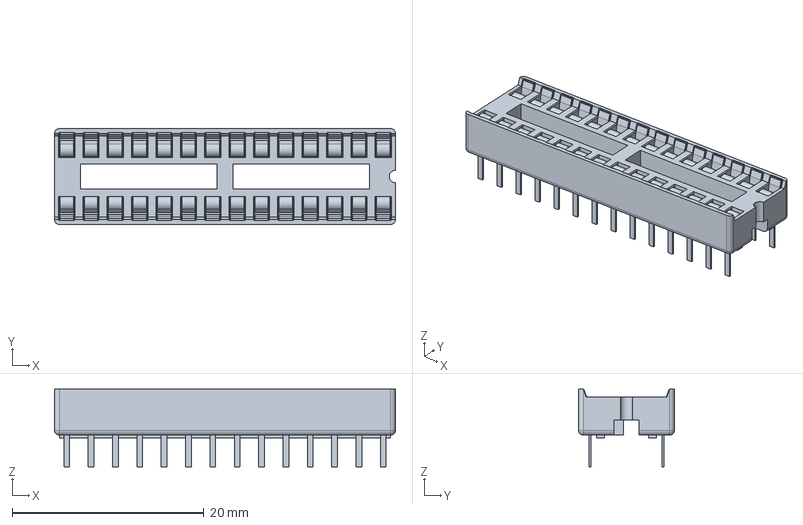
[picture p42: CAD file, 2025-05-07]
footprints/kuciste_za_mikrokontroler_28_pinova/1-2199298-9/3D/1-2199298-9.stp
35.6 x 10.0 x 8.10 mm
