sdejana/ColorSorter_C/footprints/pin_header_female_8_pinova/5-534206-4/3D/5-534206-4.stp

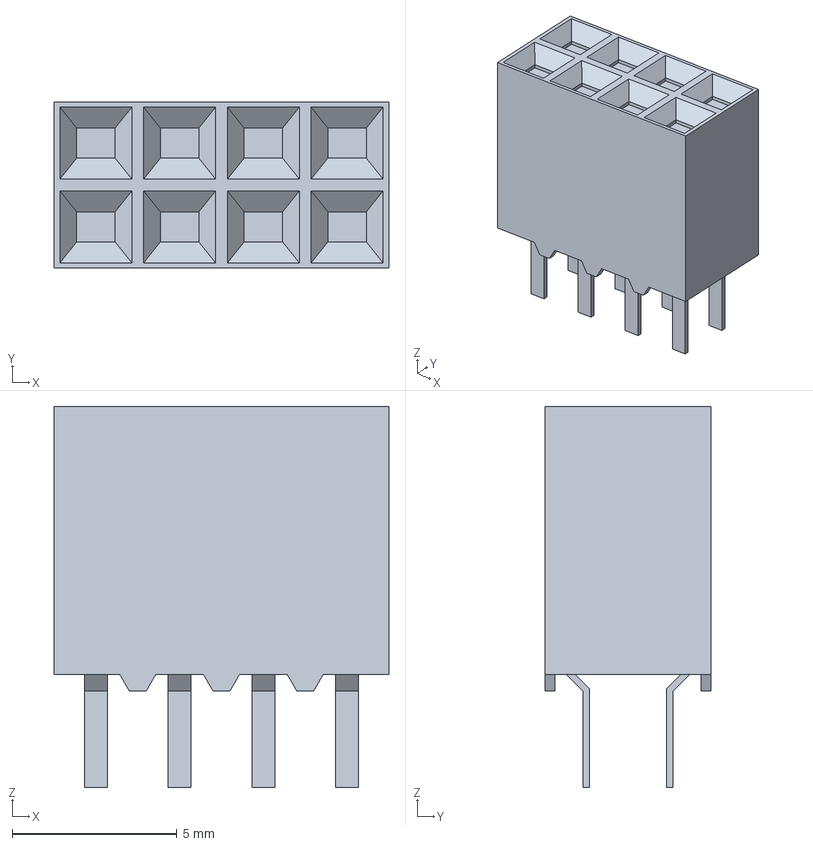
[picture p43: CAD file, 2025-05-07]
footprints/pin_header_female_8_pinova/5-534206-4/3D/5-534206-4.stp
10.2 x 5.03 x 11.6 mm
