sdejana/ColorSorter_C/footprints/10p_kondenzator_keramicki/02013A100JAT2A/3D/02013A100JAT2A.stp

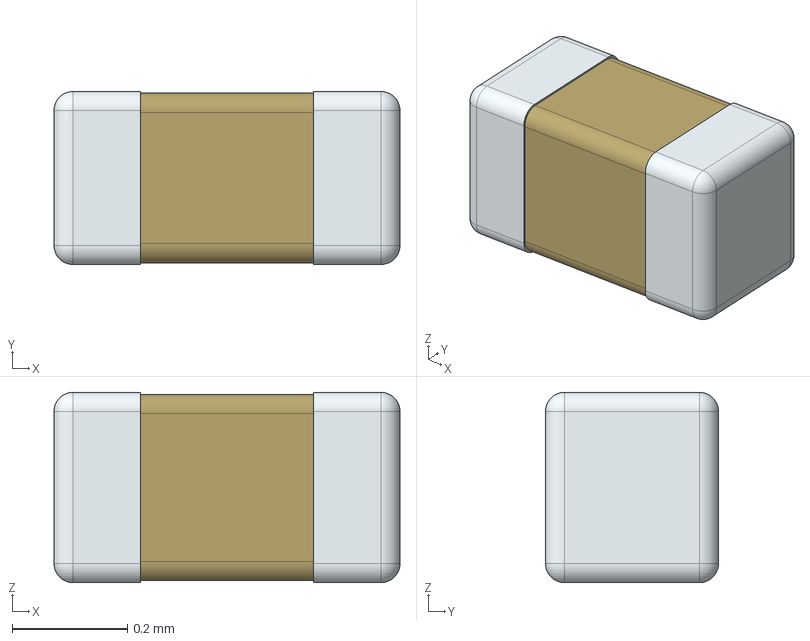
[picture p44: CAD file, 2025-05-07]
footprints/10p_kondenzator_keramicki/02013A100JAT2A/3D/02013A100JAT2A.stp
0.6 x 0.3 x 0.33 mm
