sdejana/ColorSorter_C/footprints/10u_kondenzator_elektrolitski/865230542002/3D/865230542002.stp

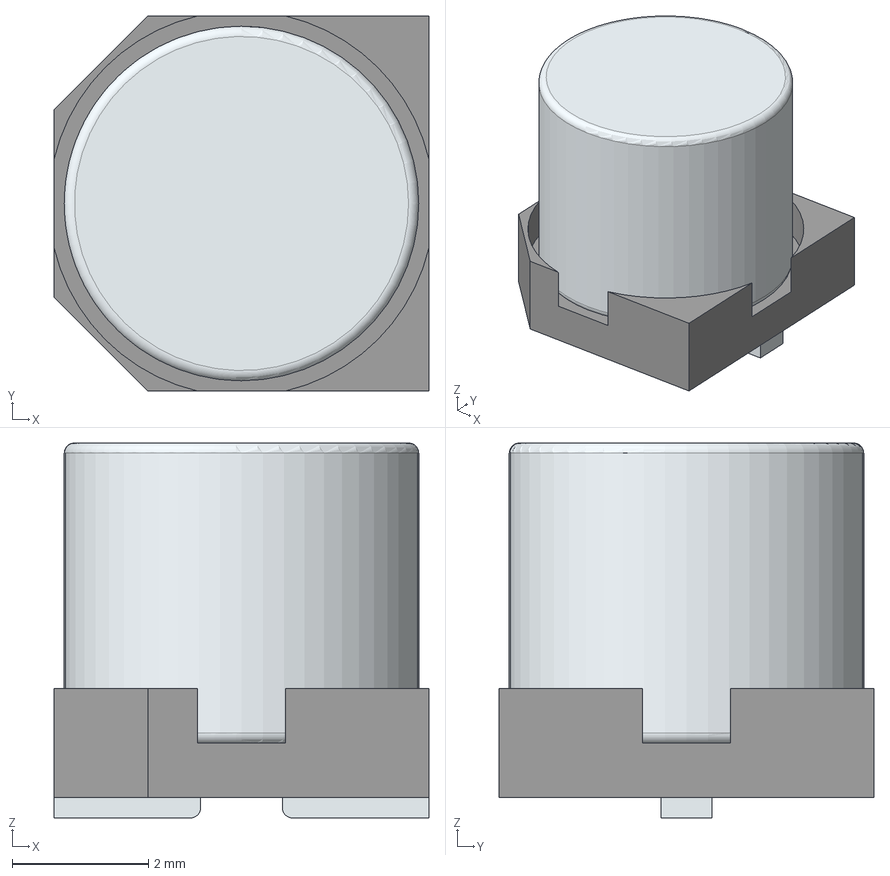
[picture p45: CAD file, 2025-05-07]
footprints/10u_kondenzator_elektrolitski/865230542002/3D/865230542002.stp
5.50 x 5.50 x 5.50 mm
Base
Pin1Fillet
Pin2Fillet
