sdejana/ColorSorter_C/footprints/pin_header_male_15_pinova/M20-9991546/3D/M20-9991546.stp

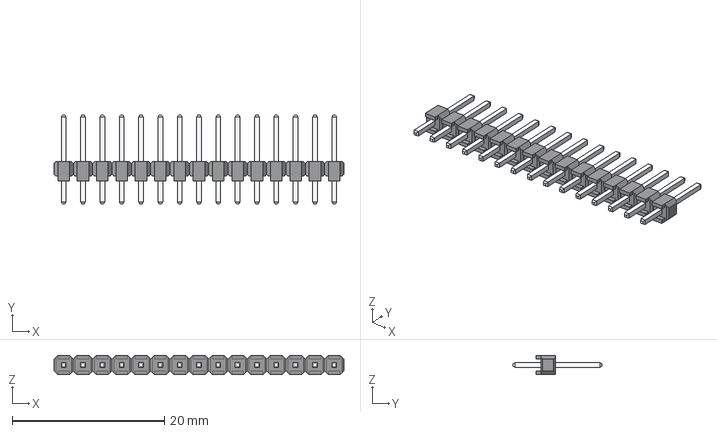
[picture p46: CAD file, 2025-05-07]
footprints/pin_header_male_15_pinova/M20-9991546/3D/M20-9991546.stp
38.1 x 11.7 x 2.54 mm
M20-999-MOULD
M20-999-PIN x 15
