sdejana/ColorSorter_C/footprints/screw_konektor_dva_izvoda/1548128/3D/1548128.stp

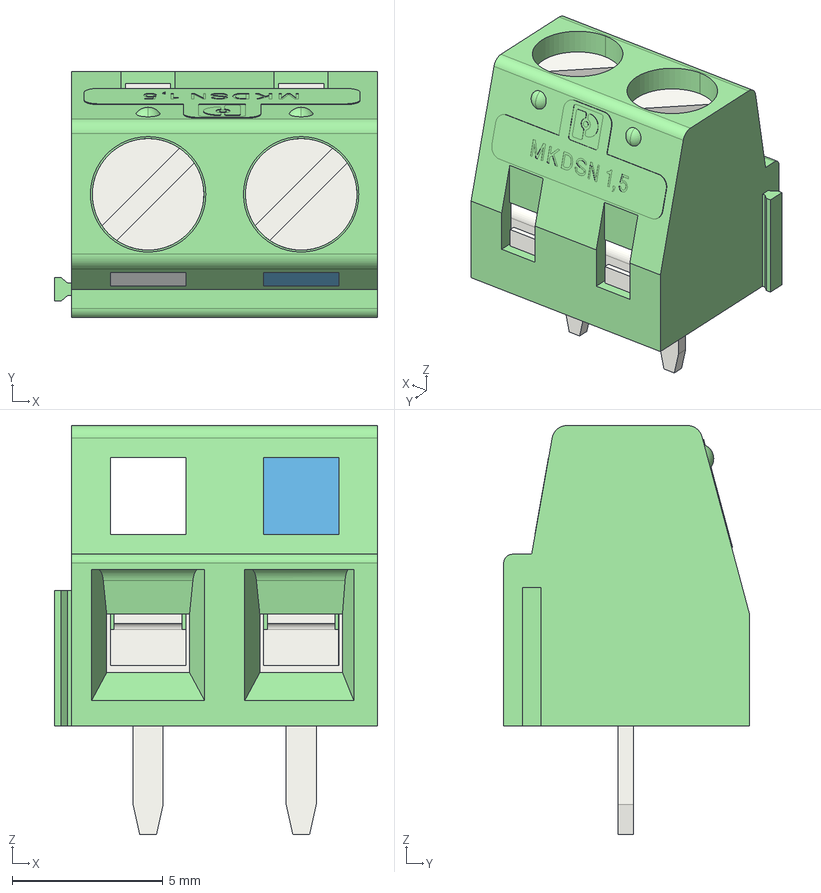
[picture p47: CAD file, 2025-05-07]
footprints/screw_konektor_dva_izvoda/1548128/3D/1548128.stp
10.7 x 8.15 x 13.6 mm
