sdejana/ColorSorter_C/footprints/screw_konektor_dva_izvoda/KF301-2P/KF301-2P.step

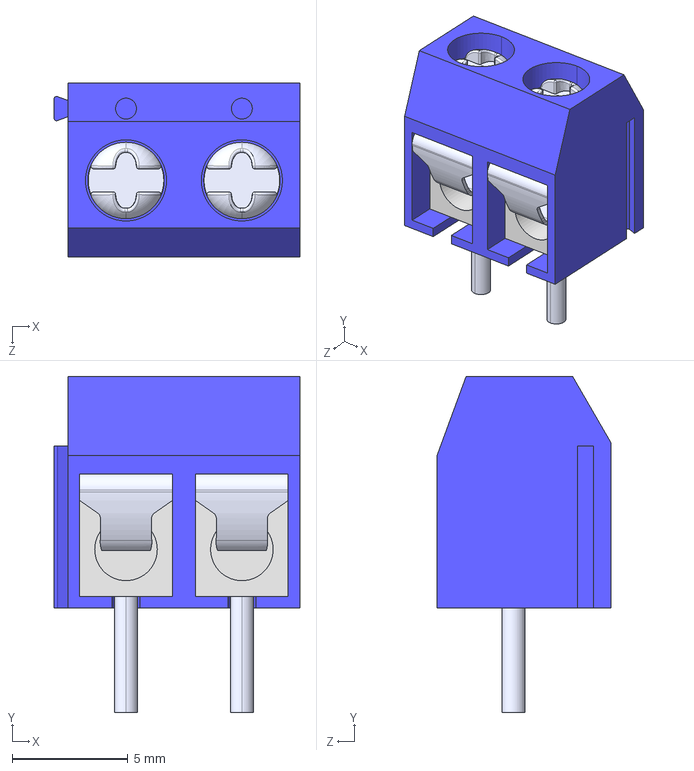
[picture p48: CAD file, 2025-05-07]
footprints/screw_konektor_dva_izvoda/KF301-2P/KF301-2P.step
10.6 x 14.5 x 7.50 mm
