sdejana/ColorSorter_C/(list of files, cad)

Other CAD files:
footprints/100u_kondenzator_elektrolitski/EEE-FT1V101AP/KiCad/6.3 SIZE CODE D.stp
footprints/0.1u_kondenzator_keramicki/C0603C104J1RACAUTO/Allegro/capc1608x95n.psm
footprints/0.1u_kondenzator_keramicki/C0603C104J1RACAUTO/DEHDL/c0603c104j1racauto/chips/chips.prt
footprints/100u_kondenzator_elektrolitski/EEE-FT1V101AP/Allegro/eee1aa101sp.psm
footprints/100u_kondenzator_elektrolitski/EEE-FT1V101AP/DEHDL/eee_ft1v101ap/chips/chips.prt
footprints/10k_otpornik/CRCW120610K0JNEA/Allegro/resc3216x60n.psm
footprints/10k_otpornik/CRCW120610K0JNEA/DEHDL/crcw120610k0jnea/chips/chips.prt
footprints/10p_kondenzator_keramicki/02013A100JAT2A/Allegro/capc0603x33n.psm
footprints/10p_kondenzator_keramicki/02013A100JAT2A/DEHDL/02013a100jat2a/chips/chips.prt
footprints/10u_kondenzator_elektrolitski/865230542002/Allegro/capae530x550n.psm
footprints/10u_kondenzator_elektrolitski/865230542002/DEHDL/865230542002/chips/chips.prt
footprints/10u_kondenzator_keramicki/C0805C106M4PACTU/Allegro/c0805.psm
footprints/10u_kondenzator_keramicki/C0805C106M4PACTU/DEHDL/c0805c106m4pactu/chips/chips.prt
footprints/1u_kondenzator_keramicki/MAASL105CD7105MFCA01/Allegro/maasx105.psm
footprints/1u_kondenzator_keramicki/MAASL105CD7105MFCA01/DEHDL/maasl105cd7105mfca01/chips/chips.prt
footprints/2.2u_kondenzator_keramicki/CL03A225MO5C65C/Allegro/capc0603x35n.psm
footprints/2.2u_kondenzator_keramicki/CL03A225MO5C65C/DEHDL/cl03a225mo5c65c/chips/chips.prt
footprints/270_otpornik/ERA-8AEB131V/Allegro/era8a__0805_.psm
footprints/270_otpornik/ERA-8AEB131V/DEHDL/era_8aeb131v/chips/chips.prt
footprints/5V_boost_regulator/LM2775DSGT/Allegro/son50p200x200x80-9n.psm
footprints/5V_boost_regulator/LM2775DSGT/DEHDL/lm2775dsgt/chips/chips.prt
footprints/kristal_kvarca/FOXSDLF_080-20/Allegro/foxsdlf08020.psm
footprints/kristal_kvarca/FOXSDLF_080-20/DEHDL/foxsdlf_080_20/chips/chips.prt
footprints/kuciste_za_mikrokontroler_28_pinova/1-2199298-9/Allegro/dips762w70p254l3556h530q28n.psm
footprints/kuciste_za_mikrokontroler_28_pinova/1-2199298-9/DEHDL/1_2199298_9/chips/chips.prt
footprints/pin_header_female_8_pinova/5-534206-4/DEHDL/5_534206_4/chips/chips.prt
footprints/pin_header_male_15_pinova/M20-9991546/Allegro/m20-9991546.psm
footprints/pin_header_male_15_pinova/M20-9991546/DEHDL/m20_9991546/chips/chips.prt
footprints/screw_konektor_dva_izvoda/1548128/Allegro/1548128.psm
footprints/screw_konektor_dva_izvoda/1548128/DEHDL/1548128/chips/chips.prt
