sdejana/ColorSorter_C/(list of files, drawings)

Other design files:
footprints/0.1u_kondenzator_keramicki/C0603C104J1RACAUTO/Altium/C0603C104J1RACAUTO.SchLib
footprints/0.1u_kondenzator_keramicki/C0603C104J1RACAUTO/Altium/CAPC1608X95N.PcbLib
footprints/2.2u_kondenzator_keramicki/CL03A225MO5C65C/Altium/CAPC0603X35N.PcbLib
footprints/2.2u_kondenzator_keramicki/CL03A225MO5C65C/Altium/CL03A225MO5C65C.SchLib
footprints/5V_boost_regulator/LM2775DSGT/Altium/LM2775DSGT.SchLib
footprints/5V_boost_regulator/LM2775DSGT/Altium/SON50P200X200X80-9N.PcbLib
footprints/10k_otpornik/CRCW120610K0JNEA/Altium/CRCW120610K0JNEA.SchLib
footprints/10k_otpornik/CRCW120610K0JNEA/Altium/RESC3216X60N.PcbLib
footprints/10p_kondenzator_keramicki/02013A100JAT2A/Altium/02013A100JAT2A.SchLib
footprints/10p_kondenzator_keramicki/02013A100JAT2A/Altium/CAPC0603X33N.PcbLib
footprints/10u_kondenzator_elektrolitski/865230542002/Altium/865230542002.SchLib
footprints/10u_kondenzator_elektrolitski/865230542002/Altium/CAPAE530X550N.PcbLib
footprints/270_otpornik/ERA-8AEB131V/Altium/ERA-8AEB131V.SchLib
footprints/270_otpornik/ERA-8AEB131V/Altium/RESC3216X70N.PcbLib
footprints/kuciste_za_mikrokontroler_28_pinova/1-2199298-9/Altium/1-2199298-9.SchLib
footprints/kuciste_za_mikrokontroler_28_pinova/1-2199298-9/Altium/DIPS762W70P254L3556H530Q28N.PcbLib
footprints/pin_header_female_8_pinova/5-534206-4/Altium/5-534206-4.SchLib
footprints/pin_header_female_8_pinova/5-534206-4/Altium/RHDR8W69P254_2X4_1016X503X877P.PcbLib
