sdejana/ColorSorter_C/docs/Mikrokontroleri sema.kicad_sch

## KiCad design docs/Mikrokontroleri sema.kicad_sch (2025-05-07)

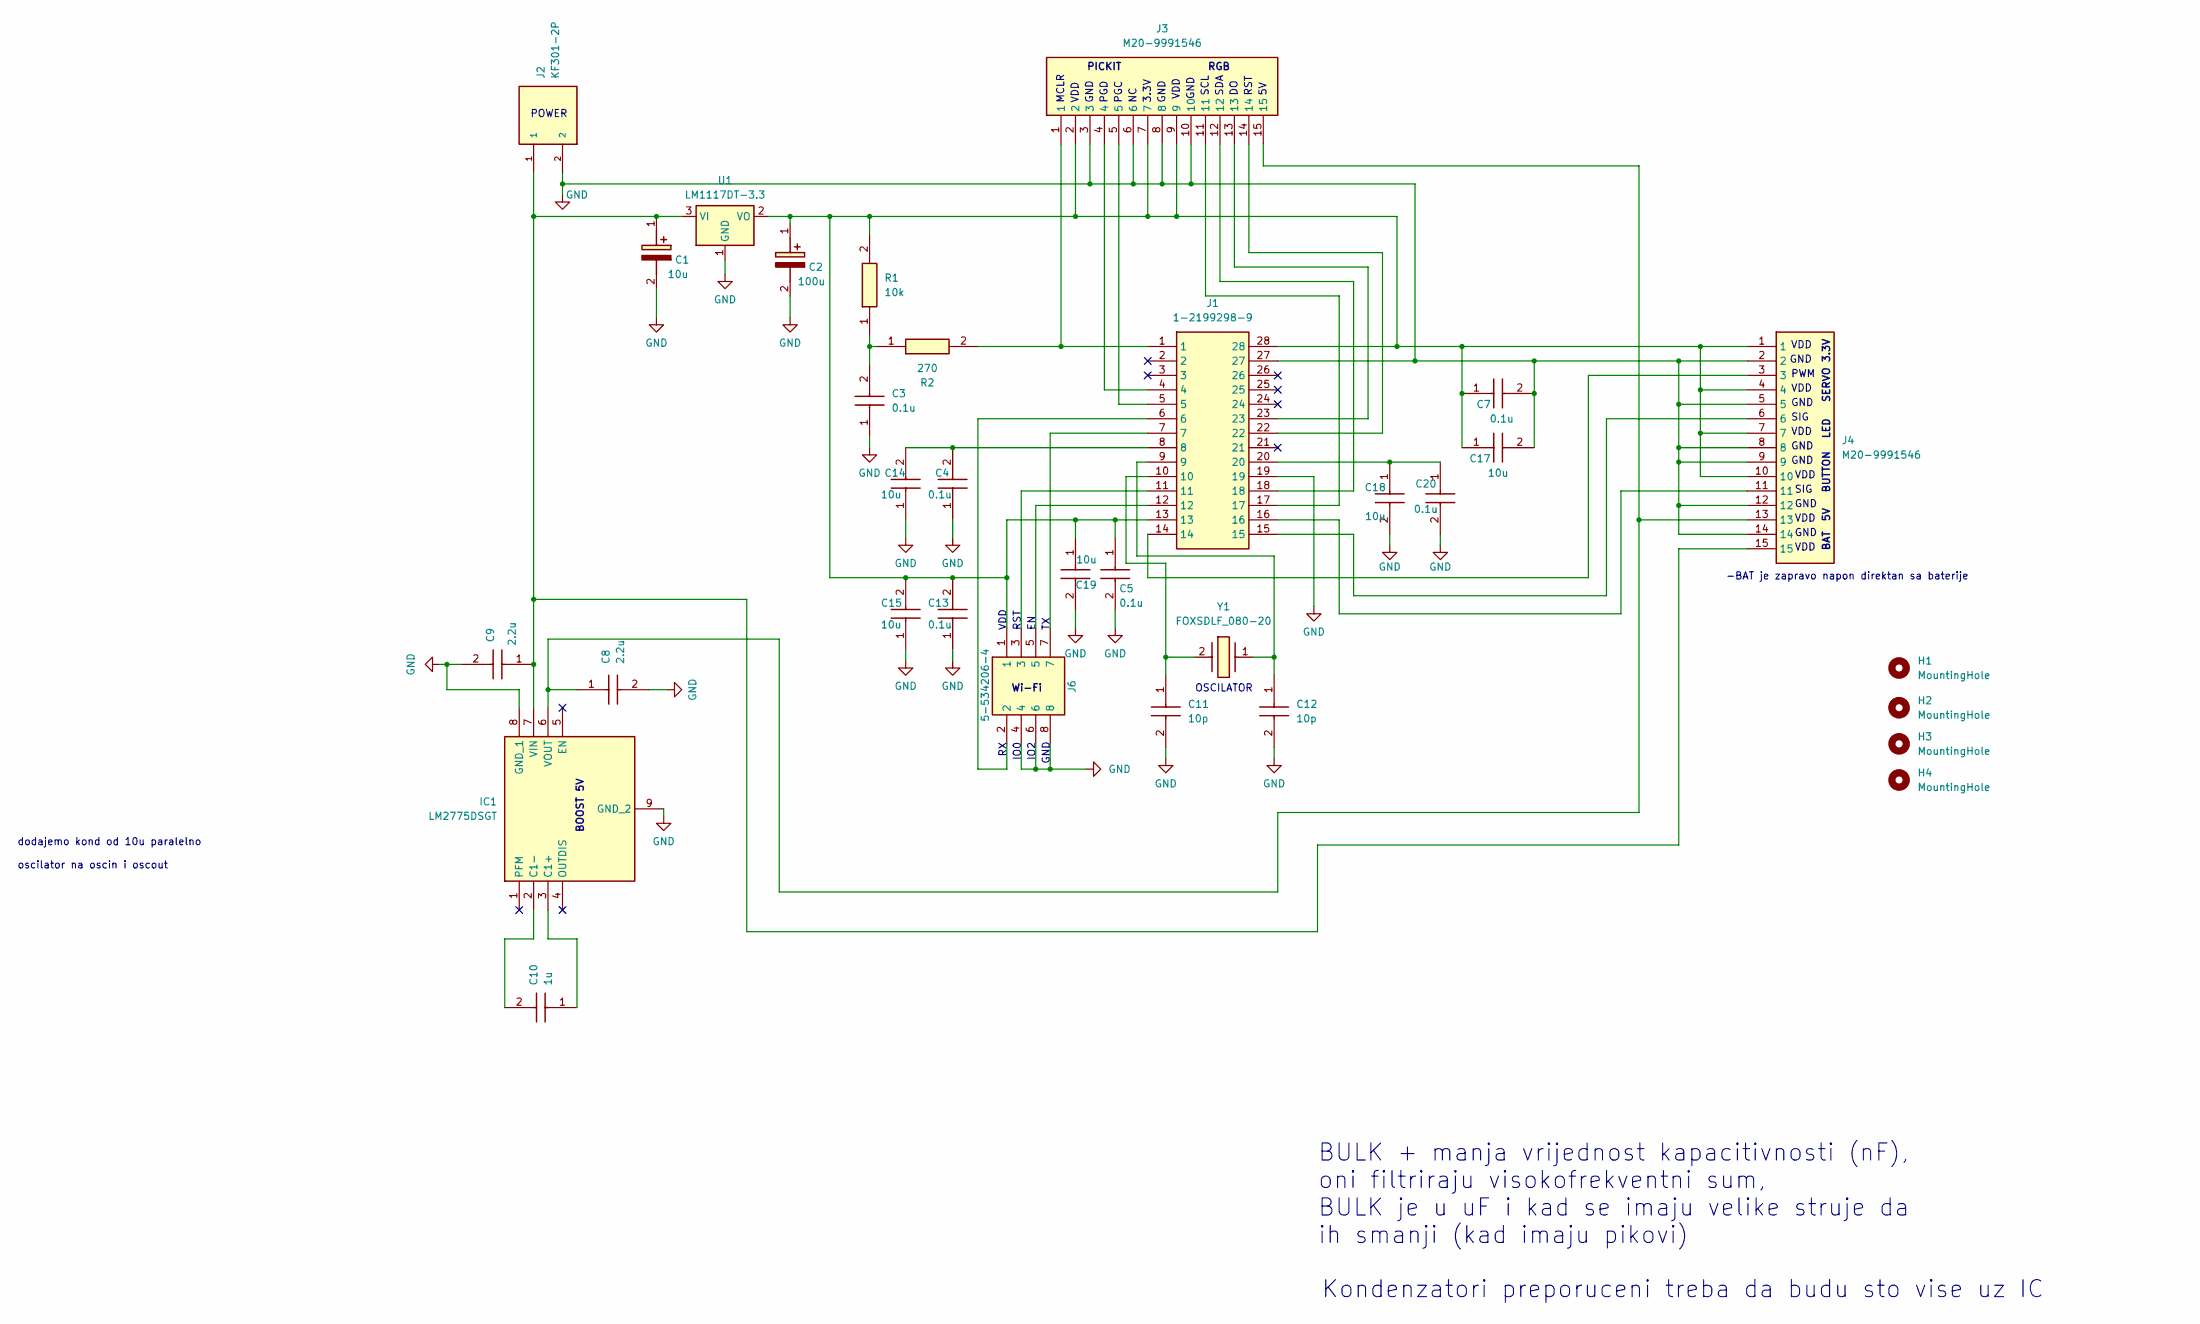
[picture p49: schematic Mikrokontroleri sema.kicad_sch]

Parts:
C1: 10u; CAPAE530X550N; Mouser Part Number 710-865230542002
C2: 100u; EEE1AA101SP; Mouser Part Number 667-EEE-FT1V101AP
C3, C4, C5, C7, C13, C20: 0.1u; CAPC1608X95N; Mouser Part Number 80-C0603C104J1RAUTO
C8, C9: 2.2u; CAPC0603X35N; Mouser Part Number 187-CL03A225MO5C65C
C10: 1u; MAASx105; Mouser Part Number 963-MAASL105CD7105MF
C11, C12: 10p; CAPC0603X33N; Mouser Part Number 581-02013A100J
C14, C15, C17, C18, C19: 10u; C0805; Mouser Part Number 80-C0805C106M4P
H1, H2, H3, H4: MountingHole; MountingHole_2.2mm_M2
IC1: LM2775DSGT; SON50P200X200X80-9N; Mouser Part Number 595-LM2775DSGT
J1: 1-2199298-9; DIPS762W70P254L3556H530Q28N; Mouser Part Number 571-1-2199298-9
J2: KF301-2P; HANDSON_KF301-2P; PARTREV NA
J3, J4: M20-9991546; Mouser Part Number 855-M20-9991546
J6: 5-534206-4; wifi; Manufacturer_Part_Number 5-534206-4; Mouser Part Number 571-5-534206-4
R1: 10k; RESC3216X60N; Mouser Part Number 71-CRCW1206J-10K-E3
R2: 270; RESC3216X70N; Mouser Part Number 667-ERA-8AEB131V
U1: LM1117DT-3.3; TO-252-3_TabPin2
Y1: FOXSDLF_080-20; FOXSDLF08020; Mouser Part Number 559-FOXSD080-20-LF

Connections:
GND: C1.2 (-), C2.2 (-), C3.1, C4.1, C5.2, C7.2, C8.2, C9.2, C11.2, C12.2, C13.1, C14.1, C15.1, C17.2, C18.2, C19.2, C20.2, IC1.8 (GND_1), IC1.9 (GND_2), J1.19, J1.27, J2.2, J3.3, J3.6, J3.8, J3.10, J4.2, J4.5, J4.8, J4.9, J4.12, J4.14, J6.4, J6.6, J6.8, U1.1 (GND)
unnamed: C1.1 (+), C9.1, IC1.7 (VIN), J2.1, J4.15, U1.3 (VI)
unnamed: C3.2, R1.1, R2.1
unnamed: C8.1, IC1.6 (VOUT), J3.15, J4.13
unnamed: C10.1, IC1.3 (C1+)
unnamed: C10.2, IC1.2 (C1-)
unnamed: C11.1, J1.10, Y1.2 (CRYSTAL_2)
unnamed: C12.1, J1.9, Y1.1
unnamed: C2.1 (+), C5.1, C7.1, C13.2, C15.2, C17.1, C19.1, J1.13, J1.28, J3.2, J3.7, J3.9, J4.1, J4.4, J4.7, J4.10, J6.1, R1.2, U1.2 (VO)
unnamed: C4.2, C14.2, J1.8
unnamed: C18.1, C20.1, J1.20
unnamed: J1.1, J3.1, R2.2
unnamed: J1.4, J3.4
unnamed: J1.5, J3.5
unnamed: J1.6, J6.2
unnamed: J1.7, J6.7
unnamed: J1.11, J6.3
unnamed: J1.12, J6.5
unnamed: J1.14, J4.3
unnamed: J1.15, J4.6
unnamed: J1.16, J4.11
unnamed: J1.17, J3.11
unnamed: J1.18, J3.12
unnamed: J1.22, J3.14
unnamed: J1.23, J3.13

Notes on the sheet:
SDA
SIG
RGB
BUTTON
-BAT je zapravo napon direktan sa baterije
GND
IO0
OSCILATOR
RST
VDD
dodajemo kond od 10u paralelno oscilator na oscin i oscout
BULK + manja vrijednost kapacitivnosti (nF), oni filtriraju visokofrekventni sum, BULK je u uF i kad se imaju velike struje da ih smanji (kad imaju pikovi)
3.3V
IO2
BOOST 5V
PGD
POWER
PGC
Wi-Fi
PICKIT
SCL
LED
BAT
Kondenzatori preporuceni treba da budu sto vise uz IC
PWM
SERVO
MCLR
