sdejana/ColorSorter_C/code/final-project-mplab-env/FINAL/system.h

 #ifndef _XTAL_FREQ
#define _XTAL_FREQ  32000000UL
#endif

#include "xc.h"
#include "stdint.h"
#include "pin_manager.h"
#include "interrupt_manager.h"

#ifndef SYSTEM_H
#define	SYSTEM_H

void SYSTEM_Initialize(void);
#endif	/* SYSTEM_H */
/**
 End of File
*/
