sdejana/ColorSorter_C/code/src/BUTTON.c

/******************************************************************************
 * Faculty of Electrical Engineering
 * MKS 2025
 * https://github.com/lukavidic/ColorSorter_C.git
 ******************************************************************************
 *
 * @file   BUTTON
 *
 * @details
 *   This file implements functions related to button handling on the
 *   microcontroller. It provides initialization and debounce checking
 *   functionalities for user input buttons.
 *
 ******************************************************************************/

#include "xc.h"
#include "BUTTON.h"
#include "CONFIG.h"
