sdejana/ColorSorter_C/(commit log)

2024-11-12 Issue #2: Dodajem datasheets za servo motor, LED modul, IR senzor. Nedostaje datasheet za button.
2024-11-25 Issue #8: Dodajem .png šeme sa dugmetom, uz opis. Svaka šema je sačuvana u KiCad programu.
2024-11-25 Issue #8: Dodajem šemu za vezivanje servo motora u kolo, s tim da je potrebno proračunati struju servo motora na osnovu datasheet-a mikrokontrolera.
2024-11-27 Dodajem uputstvo sa primjerom za dodavanje novog elementa u KiCad-u.
2024-12-01 Dodajem footprinte za komponente koje smo do sad koristili u KiCad-u, zajedno sa svim potrebnim bibliotekama.
    [C0603C104J1RACAUTO.SchLib, C0603C104J1RACAUTO.stp, C0805C106M4PACTU.stp, C2012X5R1C106K085AC.stp, CAPC1608X95N.PcbLib, CAPC2012X145N.PcbLib, CRCW120610K0JNEA.SchLib, CRCW120610K0JNEA.stp]
2024-12-07 Issue #8 i Issue #11: Dodajem analize za preostale komponente i raspored pinova za njih. Servo motor, LED modul, button modul, WiFi modul.
2024-12-12 Dodajem dokument sa pobrojanim komponentama (nedostaje cijena za screw konektor za bateriju i same baterije) i njihovim cijenama, ID u Mouser-u i ukupnom cijenom. Potrebno dopuniti.
2024-12-27 Issue #12: Dodajemo predfinalnu verziju seme. Footprinti su takodje dodani, a KiCad ne javlja greske :).
2024-12-29 Issue #12: Dodajem spisak dodatnih komponenata. Nedostaje screw konektor.
2025-01-13 Issue #3: Dodajemo prvu verziju završene PCB.
2025-01-13 Dodajem izmijenjenu strukturu footprints foldera, sa svim korištenim footprintima i razvrstanim po upotrebi/vrijednostima.
    [02013A100JAT2A.SchLib, 02013A100JAT2A.stp, 1-2199298-9.SchLib, 1-2199298-9.stp, 5-534206-4.SchLib, 5-534206-4.stp, C0603C104J1RACAUTO.SchLib, C0603C104J1RACAUTO.stp]
2025-01-23 Issue #12: Ispravljena verzija pcb-a
2025-01-29 Issue #12: Dodajem BOM i (nadam se) finalnu verziju plocice.
    [Mikrokontroleri-sema-final.csv]
2025-02-13 Dodajem konacan sspisak footprint-a, simbola i .step datoteka.
    [1548128.psm, 1548128.stp, 6.3 SIZE CODE D.stp, 865230542002.SchLib, 865230542002.stp, CAPAE1000X1050N.PcbLib, CAPAE1280X1400N.PcbLib, CAPAE530X550N-(C).stp]
2025-02-13 Issue #12: Dodajem fotografije konacnog izgleda stampane plocice.
    [BOM-file.xlsx]
2025-03-04 Issue #19: Dodajem prvi testni fajl u svrhu testiranja LED modula i programiranja mikrokontrolera.
    [main.c]
2025-03-05 Issue #17: Dodajem testni kod za LED modul (radi provjereno).
    [main.c]
2025-03-14 Issue #21: Dodajem .c fajl sa kodom koji predstavlja testni kod za WiFi modul. Test je uglavnom uspjesan.
    [wifi-test.c]
2025-03-18 Issue #21: Dodajem kod koji testira komunikaciju izmedju WiFi-ja i mikrokontrolera na baud rate-u od 115200 (povecana frekvencija na 16MHz).
    [wifi-test.c]
2025-03-28 Issue #21: Dodajem .c i .h fajl sa osnovnim funkcijama potrebnim za komunikaciju putem WIFI-ja. Dodajem i aplikaciju koja ce na softverskoj strani prikazivati promjene i omoguciti interakciju sa kori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
    [Main.java, WIFI.h, main.c, wifi-test.c]
2025-03-28 Issue NO_ISSUE: Reorganizacija foldera.
    [main.c]
2025-04-02 Issue #21: Dodajem .h i .c fajl sa potrebnim funkcionalnostima. Potrebno jos implementirati zajednicku funkciju sa RGB senzorom.
    [WIFI.c, WIFI.h]
2025-04-02 Issue #23: Dodajem trenutnu strukturu fajlova, sa izmjenama za 16MHz frekvenciju. Potrebno istestirati i doraditi. Potrebno dodati funkcije moveLeft i moveRight koje ce se koristiti u integraciji.
    [SERVO.c, SERVO.h]
2025-04-03 Issue: NO ISSUE Dodajem fajlove seme u KiCadu-u i fotografiju seme pod nazivom sema-najnovija.
    [Mikrokontroleri sema.kicad_sch]
2025-04-05 Issue #21: Apdejt koda za servo, wifi i main.
    [SERVO.c, SERVO.h, WIFI.c, main.c]
2025-04-11 Issue 22: Analiza i implementacija funkcionalnosti RGB senzora.
    [VEML3328.c, VEML3328.h, interrupt_manager.c, interrupt_manager.h, pin_manager.c, pin_manager.h, system.c, system.h]
2025-04-11 Revert "Issue 22: Analiza i implementacija funkcionalnosti RGB senzora."
    This reverts commit 8d1ed9ebaf81cdcf14f3e4fb1d1e4b1e4b1ff370.
    [VEML3328.c, VEML3328.h, interrupt_manager.c, interrupt_manager.h, pin_manager.c, pin_manager.h, system.c, system.h]
2025-04-11 Issue #22: Analiza i implementacija funkcionalnosti RGB senzora.
    [VEML3328.c, VEML3328.h, interrupt_manager.c, interrupt_manager.h, pin_manager.c, pin_manager.h, system.c, system.h]
2025-04-11 Issue #21: Dodajem potrebne .c i .h fajlove, te izmjene vezane za aplikaciju.
    [BUTTON.c, BUTTON.h, CONFIG.c, CONFIG.h, LED.c, LED.h, SERVO.c, WIFI.c]
2025-04-14 Issue #22: Dodana kalibracija senzora. Ispravljeni bagovi.
    [VEML3328.c, VEML3328.h, spi1.c, spi1.h]
2025-04-14 Issue #24: Struktura fajlova.
    [CONFIG.c, CONFIG.h, SERVO.c, SERVO.h, VEML3328.c, VEML3328.h, WIFI.c, WIFI.h]
2025-04-14 NO ISSUE: Kalibracija senzora.
    [VEML3328.c, main.c]
2025-04-17 Issue #25: Finalna verzija aplikacije.
    [CONFIG.c, Main.java, main.c]
2025-04-17 Issue #26: Dodajem prvu verziju itegracije Potrebno itegrisati Color senzor
    [BUTTON.c, BUTTON.h, CONFIG.c, CONFIG.h, LED.c, LED.h, SERVO.c, SERVO.h]
2025-04-17 NO ISSUE: Azuriranje konfiguracije.
    [CONFIG.c, VEML3328.c]
2025-04-17 NO ISSUE: Azuriranje test fajlova.
    [main.c]
2025-04-17 NO ISSUE: Azuriranje konfiguracije pt2.
    [CONFIG.c, main.c]
2025-04-18 Issue #25: Dodajem projekat sa kodom koji sadrzi integrisane sve komponente. Potrebno je jos izmijeniti funkciju stopAll(void), te eventualno smanjiti vrijeme cekanja izmedju iteracija u programu.
    [BUTTON.c, BUTTON.h, CONFIG.c, CONFIG.h, LED.c, LED.h, SERVO.c, SERVO.h]
2025-04-24 Issue #26: Verzija 3 integracije.
    [BUTTON.c, BUTTON.h, CONFIG.c, CONFIG.h, LED.c, LED.h, SERVO.c, SERVO.h]
2025-04-24 NO ISSUE: Gasenje lampice.
    [CONFIG.c]
2025-05-05 Issue #27: - Dodajem dxygen komentare za kreiranje dokumentacije - Potrebno napisati doxygen komentar za UART.c i UART.h
    [BUTTON.c, BUTTON.h, CONFIG.c, CONFIG.h, LED.c, LED.h, SERVO.c, SERVO.h]
2025-05-06 Issue #26 i #27: Dodajem finalnu verziju koda, u okviru final-project-mplab-env foldera. Takodje dodajem izgenerisanu dokumentaciju za kod, za trenutnu verziju koda.
    [BUTTON.c, BUTTON.h, CONFIG.c, CONFIG.h, LED.c, LED.h, SERVO.c, SERVO.h]
2025-05-06 Issue NO ISSUE: Reorganizacija folder strukture.
    [BUTTON.c, BUTTON.h, CONFIG.c, CONFIG.h, LED.c, LED.h, SERVO.c, SERVO.h]
